vldgeorgiev/scuba-gas-analyzer/docs/improvement-plan.md

# Current app improvement plan

Updated 2026-10-14. Implementation has started, one small step at a time, from restored `main`
at `ecde0b9`. See [progress and verification](progress.md) for completed work and pending checks.
Earlier redesign build/test results describe discarded work, not completion of this plan.

This document is the current scope and decision source. The old OpenSpec change drafts have been
removed. The earlier architecture is historical reference only. Create a small specification for
the next change when requested; do not recreate the discarded framework.

## Document guide

- Current scope and decisions: this document.
- Current delivery sequence: the numbered steps below.
- Architecture, ownership, and messaging: [architecture](architecture.md).
- Implementation status, decisions, and verification: [progress](progress.md).
- Historical only: [Earlier architecture](historical-simplified-architecture.md),
  [discarded implementation build evidence](historical-dependency-baseline.md), and
  [earlier review](historical-claude-review.md). These are not current requirements or validation.

## Scope and decisions

- Keep PlatformIO and the ESP32-S3 board. Leave `esp32dev` explicitly experimental.
- Use unmodified Adafruit ADS1X15. No driver fork, custom register driver, or transport hierarchy.
  Use its non-blocking conversion API with an application polling deadline and a Wire timeout.
  Accept that individual I2C transfer failures are not exposed and may produce plausible values.
- Preserve current gas formulas, gains, sample rate, polarity, and calibration targets initially.
  Fix invalid inputs and numerical defects separately with focused tests. No gas-model refitting,
  new temperature compensation, sensor/electrical redesign, or accuracy-certification work.
- Do not clamp finite O2/He percentages or CO ppm to nominal full-scale display values. Keep
  over-range readings visible; retain input, calibration, and finite-value guards.
- Remove `RunningAverage` and the application-level 20-conversion batches for normal gas readings.
  Use one fresh ADC conversion per enabled channel per acquisition cycle, keeping the ADC data rate
  unchanged. The ADS1115 hardware provides internal digital filtering; the Adafruit library reads
  its conversion result, rather than performing an equivalent 20-sample software average.
  Removing the extra averaging is a deliberate latency/noise tradeoff, not numerical equivalence.
- The user designs the replacement UI in LVGL Editor. LVGL 9.5.0 was explicitly approved on
  2026-09-16 and the exported C now compiles with the firmware.
- Decision 2026-09-16: activate the exported UI now; do not retain an EEZ runtime fallback. Keep
  generated sources untouched and application bindings in a handwritten adapter. Generated
  Calibration, Calibration Run, Firmware Update, and Diagnostics screens are now integrated.
- Calibration must have a live millivolt graph, cancellation, and automatic stability-gated
  completion. These are required improvements, not an indefinite backlog item.
- Add configurable inactivity sleep and button wake. CO uses a 14,000 ms post-power window and is
  Warming in that window above zero ppm; He is Warming below its policy temperature threshold. Raw mV
  remains visible.
- Keep individual Preferences keys, defaults, and one validated RAM settings value. No settings
  blobs, migration, schema versions, CRCs, redundant records, or atomic multi-key guarantees.
- Translation work (2026-10-19): use the Editor translation table for English/Bulgarian text, default
  to English, and persist language through the existing Settings save-on-exit path. UI owns preview
  and LVGL language changes; analyzer owns validation and the individual Preferences key. Keep
  generated files untouched. Language changes do not invalidate measurements or calibration.
  Translate all built-in UI text, including runtime states/results, dialogs, options, placeholders,
  firmware-update feedback, sleep failures, and displayed diagnostic messages; retain user data and
  technical symbols/units unchanged.
- Preserve existing OTA access while moving release downloads from the fixed DigitalOcean object to
  the stable GitHub Release asset URL. Versioned release automation and an on-screen firmware version
  are active scope in step 8. Authenticate GitHub and its release redirect with maintained root CAs
  after bounded NTP synchronization; fail closed when time or TLS verification fails.
- Keep the current README unchanged during planning; update user documentation after implementation.
- External O2 jack (2026-10-14): GPIO13 detection temporarily disables He/CO power and acquisition,
  preserving saved settings and the existing O2 enable/ADC path. LOW currently means plugged
  in. Keep this small: no queue clearing, generation change, new UI messages,
  or calibration-switch protection. Internal and external O2 have separate persisted air/pure
  calibration sets, selected by the jack; existing internal keys remain unchanged. Readings and
  calibration select differential A0/A1 for external O2 or A2/A3 for internal O2 on ADC1 (`0x49`);
  the jack does not switch analog wiring. Startup, polling,
  and resume use the current jack state; unplugging restores settings and normal warm-up.
  See architecture and tests.

## Design limits

- Two persistent application execution contexts: UI and analyzer. A temporary worker may perform
  Wi-Fi scan/update work without calling LVGL. No extra manager, logger, battery, or monitoring task.
- UI owns widgets and draft settings. Analyzer owns ADCs, sensor power, calibration, effective
  settings, and persistence. Callbacks submit work and return promptly.
- Use fixed-size messages: latest measurement, a small command queue, reliable completion,
  and coalesced calibration progress. No general event framework or multi-operation scheduler.
- Allow one state-changing user operation at a time. Cancellation targets that operation; startup
  calibration uses the same busy state. Define queue-full and late-cancel behavior explicitly.
- Keep one measurement-generation counter to reject cached readings from before settings changes.
  Ordinary settings drafts must not overwrite calibration coefficients.
- Prefer concrete components and free functions. Keep only test boundaries that provide useful
  failure coverage. Do not prescribe a new directory tree or rename working files for appearance.
- Use fixed-capacity application buffers. Do not promise allocation-free internals in third-party
  libraries. Measure actual heap/stack demand before optimizing.

## 1. Establish a small verification baseline

Record and pin the currently working dependency set without upgrading it. Keep debug/release
profiles, a native test command for portable production logic, and automated checks for tests and
target builds. Add tests as behavior is changed, not a complete fake infrastructure upfront.
Validate a small Editor export independently so it does not delay urgent correctness fixes.

Acceptance: documented build/test commands and unchanged USB/touch configuration.

## 2. Make readings and failures predictable

Progress: normal-reading batch averaging is removed (step 2a); initialized readings, conversion
guards, checked integer presentation, and cycle error reset are implemented (step 2b).
Latest-only measurement publication and UI-clock stale suppression are implemented (step 2c).
ADC polling deadlines and independent readiness/retry are implemented (step 2d). Explicit channel
state and a temporary status-label adapter are implemented (step 2e). See
[verification details](progress.md).

Initialize every measurement field. Distinguish disabled, warming, valid, invalid, and unavailable;
compute staleness in the UI even when acquisition stops. Never replace unknown values with zero
or show the last good value as current. Guard MOD, denominators, non-finite values, and integer
conversions. Apply the existing He correction when O2 is enabled and usable; use the uncorrected
baseline when O2 is disabled. Preserve raw diagnostics.

Use stock Adafruit conversion start/poll/result calls with a timeout. Initialize ADCs independently,
retry failed initialization or observed timeouts with simple backoff, and read temperature only
when needed. Preserve ADC gains and data rate, but replace each 20-conversion gas batch with one
fresh conversion. Neither range checks nor the polling deadline prove that an individual I2C
exchange succeeded.

Remove the normal-reading average buffers and do not replace them with another smoothing filter.
With all channels enabled at 128 SPS, this reduces the conversion count from 61 to 4 per cycle:
approximately 477 ms to 31 ms of nominal conversion time, excluding bus and scheduling overhead.
This reduces acquisition latency but does not automatically increase UI refresh frequency; review
the task wait interval so a fixed delay does not hide the benefit. Do not automatically reintroduce
smoothing if noise rises; review the tradeoff.

The `RunningAverage` dependency was retired after calibration moved to the bounded stability window
in step 5. That window is evidence for calibration, not normal-reading smoothing.

Acceptance: focused tests for invalid/disabled values, stopped producer, independent readiness,
timeout/recovery, clock wrap, and exactly one fresh conversion per enabled channel (temperature only
when needed). Verify readings are derived from that conversion without a batch average. Target stale
indication within two seconds of the last usable sample, including UI refresh latency. The stock
library cannot detect every bus failure.

## 3. Establish task ownership and add sleep

Decision updated 2026-09-15: bring the full analyzer/UI task restructuring forward from step 4
to avoid accumulating temporary synchronization. Step 3a's interim gate is replaced by step 3b:
one analyzer task, one UI task, and a small fixed command/result path. The gate, `configOpen`,
GUI mutex, separate screen-update task, and arbitrary startup delay are removed.
Step 3c implements analyzer-owned preparation/resume and the fixed CO startup interval. Step 3d
adds the persisted timeout, configuration dropdown, and tested activity/debounce policy. Step 3e
enables S3 automatic entry, display/touch shutdown, abort/resume, and GPIO14 wake with confirmed-wake
calibration preservation.

The analyzer owns ADCs, sensor-enable GPIOs, calibration, effective RAM settings, and Preferences.
UI callbacks submit one operation at a time and receive an outcome with effective values and a
measurement generation. Acquisition continues while settings are open. Calibration runs as an
incremental analyzer-owned session with cancellation and bounded progress.
The UI initializes and updates all graphics objects in one task. Block the unused Arduino loop.

Default timeout: 5 minutes. Options: Off, 1, 2, 5, 10, and 30 minutes; wake on GPIO14/button 2.
Persist the selected timeout; use 5 minutes when the stored value is missing or invalid.
Measure touch/button inactivity, not redraws. Inhibit sleep during calibration, pending settings,
Wi-Fi scans, and OTA using explicit activity flags, not a nested inhibitor registry. Start a fresh
idle interval after operations finish.
Keep sleep inhibited while Settings is open so its current draft is not lost to sleep. Closing
submits the draft; if saving is rejected, restore effective settings and do not retain those edits.

Deliver ownership and sleep against the existing UI before the replacement UI. Reuse the analyzer
command path for sleep preparation/resume and owner-driven sensor power timing. No more temporary
shared-access gates. Do not wait for the Editor export or hand-edit generated UI output.

Ask the analyzer to prepare for sleep with an ID and timeout. Reject preparation while busy.
After acknowledgement, power down the display/touch/backlight and radio as supported, then enter
deep sleep. An aborted preparation must restore usability and resume acquisition; ignore late
acknowledgements. Keep this a small explicit sequence, not a general rollback framework.

Validate the expected wake cause plus a simple consumed application-sleep marker. Load persistent
settings and skip automatic startup calibration only on confirmed application wake. Restart the
CO interval. Report missing/invalid calibration; do not present it as an accepted calibration just
because a numerical default exists. Wait for button release before arming and consume/debounce
the wake press. Configure GPIO output hold/pull behavior according to the board requirements.

Acceptance: five-minute default, missing/invalid timeout fallback, Off and all timeout options,
busy inhibition, abort/resume, held button, and retained settings.

## 4. Finish settings behavior and acceptance

Ownership, RAM settings, complete-candidate validation, checked changed-key writes, acknowledged
reset/clear, and generation filtering have moved into step 3b because the task handoff needs them.
Do not repeat that restructuring. Keep individual Preferences keys and explicit best-effort
persistence: a failed multi-key write may have stored a prefix even though runtime state is retained.
An in-session retry rewrites the complete candidate before reporting success after such a failure.

Step 4a implements field-specific invalid-load recovery, preserving unrelated valid values and
repairing dependent pO2/O2 pairs. It retains the visible warning and startup-calibration suppression
when non-timeout fields need repair. No load-time writes, versioning, or migration machinery added.
Step 4b validates stored O2-air and He calibration independently on cold boot and wake. Unrelated
repairs preserve accepted calibration; missing/invalid channels suppress affected derived readings.
Ordinary saves cannot accept RAM fallback coefficients. Existing float keys retain NaN for unaccepted
calibration, and explicit successful calibration/reset accepts only its own channel. Results name
required channels; raw O2/He diagnostics remain available. Step 4c was simplified at the user's request:
save on exit, restore effective settings and report failure if rejected, and do not retain failed edits.
One editing flag prevents asynchronous results overwriting an open editor. No discard controls or
retained-draft sleep inhibition; only the open editor and pending operations inhibit sleep.
Save-on-exit and apply/reset/clear behavior are implemented.
Calibration-required reading labels use the existing Invalid state; detailed calibration outcomes
identify the channels that require calibration.
Check that calibration outcomes cannot overwrite in-progress editable settings drafts, and that
old-generation readings never accompany new coefficients. Keep tests focused on product behavior.

Step 4d (2026-10-14) adds a persisted CO correction setting (+2 to -5 ppm, default 0, added to the
measured value) to the
existing Settings save-on-exit path; see architecture. Host tests cover storage, repair, mapping,
and subtraction.

Acceptance: tests cover retained settings and reset/clear behavior, write failures are reported
accurately, and display updates do not repeat NVS reads. No new store framework.

## 5. Complete stability-gated calibration

Implementation status: manual and enabled cold-boot calibration share one incremental session.
Spread and drift qualification, cancellation, persistence-gated completion, and legacy averaging
removal are complete with the current thresholds.

Use one incremental calibration session for manual and enabled cold-boot calibration. Collect fresh
timestamped millivolt samples into a fixed rolling window. Require minimum sample count/coverage,
low spread and low drift. Decision 2026-09-17: add drift detection to the existing rolling-range
check; additional sample-gap qualification and continuous stable dwell are not in scope for now.
Keep existing invalid-sample handling and the five-second minimum/ten-second maximum session.
Never force acceptance merely because time elapsed.

Feed the window individual fresh conversions, not pre-averaged batches. Replace calibration's
`RunningAverage` objects with this fixed-capacity history and remove the library dependency once
unused. A mean of the final qualified window may still be used to estimate the coefficient; this
does not restore continuous smoothing to normal measurements.

Compute the candidate from the final stable window, validate, persist, then apply. Cancellation,
sampling failure, invalid input, timeout, and reported write failure retain the previous live
calibration. Define late cancellation after successful application as already completed, not undone.
Publish bounded history/progress independently of screen refresh. Thresholds are code constants,
not new user-facing settings. Accept O2-air candidates from 5 through 20 mV, pure-O2 candidates from
30 through 100 mV, and helium candidates at or above 400 mV. Calibration and warm-up constants are
centralized in `src/app/AnalyzerPolicy.h`. No CO calibration workflow is added.

Acceptance: tests for steady input, noise, positive/negative slow drift, settling, spikes, timeout,
cancellation, and clock wrap. Sample-gap and additional dwell changes are deferred. A hidden or slow
graph must not change the result. Use bounded acquisition steps only if needed, without changing ADC
rate or adding another task.

## 6. Integrate the replacement UI

### Active migration checklist (2026-09-16)

- [x] Compile checked-in exported C, fonts, and images with LVGL 9.5.0 in both S3 profiles.
- [x] Exclude EEZ from the active firmware; replace `ui_init`, `ui_tick`, Flow globals, and direct
  EEZ widget references. Keep existing analyzer/UI ownership and message queues.
- [x] Initialize unavailable readings before loading Main. Bind percentages, mV, He temperature,
  guarded Bottom/Deco MOD, battery, warning-log indicator, and CO danger-colour policy.
- [x] Wire Main/Large screen taps after all permanent screens exist. Keep Settings/Calibration
  actions separate, create Settings on entry, and delete it after returning to Main.
- [x] Connect settings subjects to open/save callbacks, index conversion, effective-value rollback,
  brightness preview, sleep policy, and calibration-coefficient protection.
- [x] Integrate generated Calibration, Calibration Run, Firmware Update, and Diagnostics screens.
- [x] Test real LVGL initialization/rendering, navigation, settings rejection and lifetime, sensor
  status formatting, and all existing portable behavior. Compile debug and release firmware.
- [x] Re-export the renamed logo object in the Editor and verify direct-library builds and host tests.
- [x] Prepare component-based `calibration.xml`, `firmware_update.xml`, and `diagnostics.xml`.
- [x] Export and verify the new screens, wire their controls, and remove handwritten action dialogs.
- [x] Implement manual calibration graph/progress/cancellation UI and stability gating.
- [x] Route enabled cold-boot calibration through the timed session and remove `RunningAverage`.
- [x] Delete the retired EEZ project, generated runtime/assets, unused widget test fakes, and
  obsolete PlatformIO exclusions. Git history retains the previous implementation.

Build integration uses `lvgl-ui-project/library.json` and a local
`gas-analyzer-ui=symlink://lvgl-ui-project` dependency. PlatformIO compiles exported sources directly,
excluding simulator/preview/tests. The Python build hook, staging, and logo workaround are removed
after a fresh Editor export. No checked-in generated C is manually edited. The library enables
uninitialized-variable build errors to catch regressions such as the former logo-name collision.
Firmware callbacks replace generated navigation listeners after initialization, retaining their
delete-time cleanup callbacks. This handles permanent-screen creation order and avoids capturing
a NULL destination. Keep styles deferred; only safety status presentation and required layout
behavior are adjusted during integration.

Generated action screens use fixed navigation beside scrolling content, global spacing tokens,
and existing components. Calibration exposes the startup preference, Air/Pure-O2/He calibration,
Pure-O2 clear, and Diagnostics navigation. Firmware Update exposes
network selection, scan, a masked password field and keyboard, connection status, and Install.
Its keyboard takes layout space rather than covering the password; other form controls hide while
editing. Install starts disabled until the adapter sets `update_can_install`.
Diagnostics shows a wrapping `diagnostics_log_text` subject. These controls are wired through
`UiAdapter`. In particular, `update_back` intentionally has
no screen-create event: integration must return to the existing Settings draft without recreating it.
XML syntax/reference checks are not a substitute for a fresh Editor export, rendering, and
keyboard/navigation tests.

Bind the user's actual Editor export through a thin adapter. Preserve normal/large readings, MOD,
channel settings, calibration/reset, startup calibration preference, brightness, battery, logs,
fault status, OTA access, and sleep configuration. Add the calibration graph, elapsed time,
stability status, Cancel, and a retained final result. Do not invent generated filenames in advance.

The retired UI sources/assets and handwritten action dialogs are removed. Shared component styling
remains the source for generated controls.

Acceptance: compatible export compiles, regeneration preserves handwritten code, navigation stays
responsive, and invalid/disabled/warming states are understandable. Consult the LVGL MCP server
and verify APIs against the selected version before implementation. Export compilation and host
adapter behavior are verified. A future Editor change should still be regenerated and built before
delivery.

## 7. Measured cleanup

Decision 2026-09-17: retain the existing Diagnostics screen and logging behavior. The device is used
for short sessions and can be reset to clear errors. A new log buffer, separate active-fault tracking,
recovery history, and duplicate rate-limiting are not required; do not implement that redesign.

Decision 2026-09-17: cache the ESP battery ADC characterization instead of rebuilding it for every
sample. Battery sampling cadence, rounding/truncation changes, buffer or scheduling optimization,
and additional operational documentation are not current issues and are not active work.

The one-time battery ADC initialization is implemented in the display-owned battery module. The
fixed-capacity UI log now copies a caller-owned snapshot while locked rather than returning mutable
shared storage; its visible behavior is unchanged. No further measured cleanup is planned unless
device behavior identifies a concrete problem.

## 8. Automate tested, versioned releases

Decision 2026-09-18: automated push CI is removed. The manually dispatched release workflow owns
host testing, release compilation, packaging, and publication. The GitHub Release OTA URL and the
on-screen compile-time version are implemented. OTA uses CA-validated TLS after bounded NTP setup.

### Local verification

There is no workflow on push or pull request. Run both host environments locally before ordinary
changes:

```sh
pio test -e native -e native-ui
```

Run relevant S3 builds locally according to the affected surface. These checks do not tag, publish,
upload, flash, or perform OTA.

### Manual release

The separate `workflow_dispatch` release workflow operates on the explicitly selected commit,
uses a concurrency group to prevent two releases allocating the same version, and requires
`contents: write`. Restrict release commits to the default branch unless an intentional override is
designed later.

Use UTC CalVer tags in the form `vYYYY.MM.DD` for the first release of a day. Additional releases on
the same date use `.2`, `.3`, and so on. Derive the next value from existing matching repository tags;
legacy `.1` tags count as the first daily release. Do not use run number as the public version.
Existing non-CalVer tags such as `proto-board-1` do not participate. The same calculated value must
identify the Git tag, GitHub Release, metadata, and compiled firmware.

The release workflow must:

1. Check out full history and tags, calculate and validate the next CalVer, and fail if the tag exists.
2. Run `pio test -e native -e native-ui` before packaging.
3. Build `t-display-s3-release` once with the calculated version injected as a compile definition.
4. Package `.pio/build/t-display-s3-release/firmware.bin` without rebuilding it under another version.
5. Generate a SHA-256 checksum and metadata containing at least version and commit SHA.
6. Create the immutable GitHub Release with `firmware.bin`, checksum, and metadata assets.
7. Create/push the tag for the exact tested commit only after validation and packaging have succeeded;
  avoid leaving a published tag when release creation fails, or make reruns idempotently recoverable.

The GitHub Release asset is the durable OTA publication surface and provides the stable anonymous
device URL.

### Firmware version and update screen

One application-owned compile-time firmware version constant supplies the UI. Ordinary local, debug, and CI builds
use an explicit development fallback such as `dev`; the release workflow injects the calculated tag.
Avoid deriving the displayed value at runtime or maintaining an independently edited version file.
The release workflow supplies the compile definition through PlatformIO's documented
`PLATFORMIO_BUILD_FLAGS` environment override.

The Editor export defines `firmware_version_text` and binds it to the `firmware_version` label on the
Firmware Update screen. `src/display/UiAdapter.cpp` copies the compile-time constant into that subject
before the transient screen opens. `test_exported_ui` asserts that the bound label equals the compiled
value, including the development fallback in host tests.

### OTA publication URL

The updater's download target is the stable latest-release asset URL:

```text
https://github.com/vldgeorgiev/scuba-gas-analyzer/releases/latest/download/firmware.bin
```

The release workflow must always attach the asset with the exact name `firmware.bin`; versioning
belongs in the tag, release title, and metadata rather than the OTA asset filename. Preserve
redirect following through GitHub's `latest` endpoint to release asset storage.

### TLS authentication

The update worker synchronizes UTC from three NTP servers with a ten-second timeout before opening
HTTPS. `WiFiClientSecure::setCACert()` receives concatenated USERTrust ECC and ISRG Root X1 trust
anchors, covering `github.com` and `release-assets.githubusercontent.com` respectively. Time setup,
certificate validation, hostname validation, or connection failure cancels the update; there is no
insecure fallback. Review the redirect chains and replace trust anchors before their 2038 and 2035
expirations or when GitHub changes its chains.

Acceptance: a manual release passes both host suites and produces one CalVer used consistently by the
binary, screen, tag, GitHub Release, and metadata; checksum verification passes; the latest-release
URL returns that exact binary; local
builds show `dev`; reruns and same-day releases cannot overwrite or ambiguously reuse a version.
TLS trust authentication must fail closed when NTP or certificate validation fails.

## 9. Migrate to LVGL 9.6.0

This is future work. Keep LVGL 9.5.0 pinned until the installed LVGL Editor and its exporter support
9.6.0, then upgrade the Editor project, generated library, firmware dependency, host tests, and
configuration together. Follow the official
[LVGL 9.5 to 9.6 migration guide](https://lvgl.io/docs/open/changelog/migration-v9-6#lv_obj).
LVGL 9.6 is the final v9 release, and APIs deprecated there are removed in v10.

- [ ] Confirm LVGL Editor can target 9.6.0 and regenerate the project without hand-editing exported C.
- [ ] Refresh `lv_conf.h` from the 9.6 template and reapply this project's settings, including the
  72 KiB memory pool, explicit color format, enabled widgets, fonts, and host-test configuration.
- [ ] Use the 9.6 public include layout and remove direct private or compatibility-mapped API usage.
- [ ] Migrate generated and handwritten Subjects from `lv_subject_init_*`/`lv_subject_deinit` values
  to `lv_subject_create`/`lv_subject_delete` pointers, preserving initial values, ranges, and buffer
  lifetimes.
- [ ] Replace generic object flag calls with dedicated APIs such as `lv_obj_set_hidden()` and
  `lv_obj_is_hidden()`; audit other renamed or deprecated object, display, span, and widget APIs.
- [ ] Move disabled-sensor visibility to shared O2, He, and CO Subjects only when the 9.6 Editor
  exports the supported boolean binding (`lv_obj_bind_bool(..., lv_obj_set_hidden)`). Do not introduce
  the deprecated `lv_obj_bind_flag_if_*` family. If the exporter cannot represent this binding, keep
  visibility in `UiAdapter` with `lv_obj_set_hidden()` until it can.
- [ ] Build with deprecation warnings visible and remove reliance on the v9.5 compatibility map.
- [ ] Run `pio test -e native -e native-ui` and build both S3 profiles before changing the pinned
  version.

Acceptance: a fresh 9.6.0 Editor export and all handwritten code compile without LVGL deprecation or
compatibility warnings; host suites and both firmware profiles pass; generated sources remain
untouched.

## Deferred

- This low-risk device does not require an OTA manifest, downgrade policy, or rollback protocol.
- Rotation, remembered screen, translations, units, calculators, and startup-calibration change warnings.
- ADC rate changes/interleaving, polynomial optimization, DMA, and display-driver replacement.
- New gas models, chemistry/hardware research, and additional power modes or wake sources.

## Implementation order

Deliver the baseline and reading fixes (1-2), then task ownership and sleep/wake (3), remaining settings
behavior (4), calibration (5), the replacement UI (6), measured cleanup (7), and versioned release
automation (8). Defer the coordinated LVGL 9.6.0 migration (9) until Editor/export support is verified.
Editor compatibility can proceed independently. Keep one current
checklist per active change. Do not resume the discarded redesign. Update architecture and progress
alongside meaningful changes. Use Claude for bounded independent review when useful, particularly
sleep and calibration; no OpenSpec scaffolding is required for small changes.
