vldgeorgiev/scuba-gas-analyzer/docs/images/box/readme-front.png

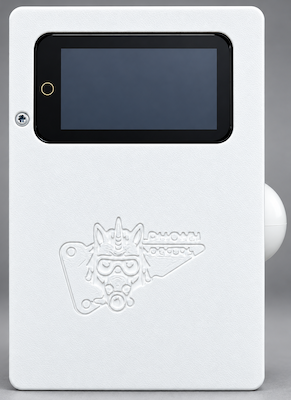
docs/images/box/readme-front.png
