vldgeorgiev/scuba-gas-analyzer/docs/images/box/readme-inlet.png

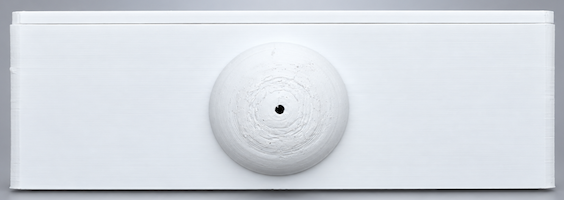
docs/images/box/readme-inlet.png
