vldgeorgiev/scuba-gas-analyzer/docs/images/box/readme-side.png

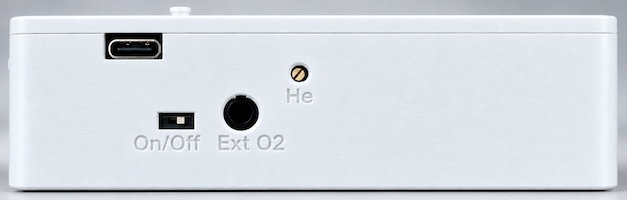
docs/images/box/readme-side.png
