vldgeorgiev/scuba-gas-analyzer/hardware/enclosure/exports/parts.3mf

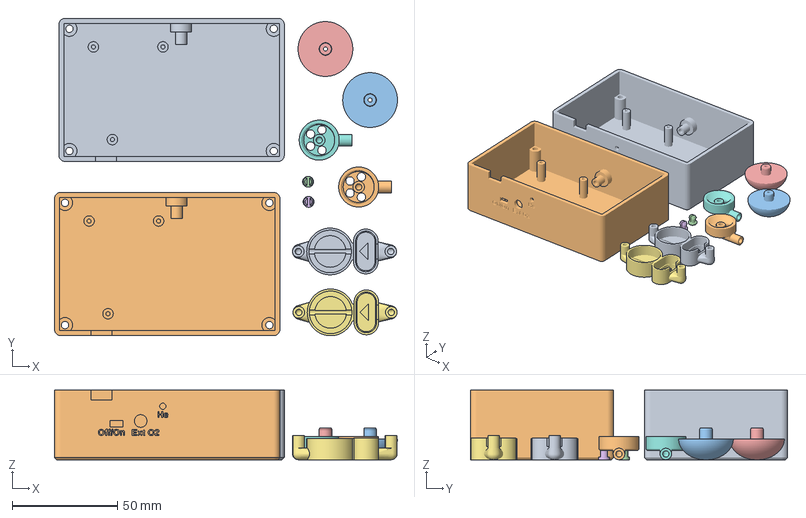
[picture p9: CAD file, 2026-10-30]
hardware/enclosure/exports/parts.3mf
162.8 x 150.7 x 33.0 mm
enclosure.stl x 2
flow_limiter.stl x 2
wake_button_pin.stl x 2
co_he_sensor_holder.stl x 2
o2_sensor_holder.stl x 2
