vldgeorgiev/scuba-gas-analyzer/hardware/enclosure/exports/lid_inlay.3mf

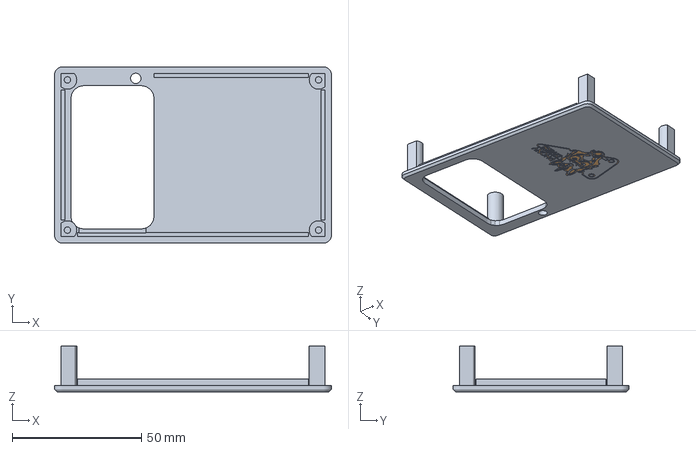
[picture p10: CAD file, 2026-10-30]
hardware/enclosure/exports/lid_inlay.3mf
107.0 x 68.0 x 17.7 mm
lid
lid_logo
