vldgeorgiev/scuba-gas-analyzer/docs/user-manual.bg.md

# Ръководство за работа с газовия анализатор

Този анализатор е самоделно устройство и не е сертифициран. Употребата му е на ваша отговорност.

## Измерване на газ

Включете анализатора и изчакайте всички включени сензори да се стабилизират. Главният екран показва съдържанието на кислород, хелий и въглероден оксид, състоянието на батерията и напреженията на сензорите. Докоснете областта с показанията, за да превключите между компактния изглед и изгледа с големи цифри.

Главен екран с показания

Екран с големи цифри

`Загрява` (`Warming`) означава, че сензорът все още не е готов. `Стари данни` (`Stale`) означава, че няма скорошно валидно измерване; изчакайте ново показание, преди да разчитате на него. `Няма данни` (`Unavailable`) означава, че липсват данни от сензора или от допълнително измерване, необходимо за изчислението. Докоснете индикатора за предупреждение, за да отворите **Диагностика** и да видите последните предупреждения и грешки.

### MOD, CO и батерия

Стойностите `B` и `D` под показанието за кислород са максималните работни дълбочини (MOD). Те се изчисляват от измерения процент кислород и зададените в **Настройки** граници за парциалното налягане на кислорода (ppO2). `B` използва настройката **Дънно pO2**, а `D` - **Деко pO2**. Проверете избраните граници и анализа на газа, преди да използвате тези дълбочини.

Показанието за CO се оцветява в червено при стойност над 0 ppm. Проверете газа и не го използвайте, докато не бъде потвърдено, че е безопасен.

Напрежението на напълно заредената батерия е около 4,2 V. Заредете я, преди напрежението да спадне до около 3,0 V. Настройката **Заспиване** определя след колко минути бездействие анализаторът да премине в режим с ниска консумация. Изберете `Никога` само ако е необходима непрекъсната работа. Заспиването значително намалява разхода на батерията, когато уредът не се използва. Не изключвайте анализатора по време на обновяване на фърмуера.

## Външен O2 сензор

Свържете външния сензор за O2 към коаксиалния жак. Анализаторът го разпознава и изключва
захранването на сензорите за He и CO, без да променя запазените им настройки. След разкачване
уредът отново използва вътрешния сензор за O2 и възстановява текущите настройки за He и CO.
Изчакайте включените сензори отново да се стабилизират. O2 трябва да е включен в **Настройки**.

За вътрешния и външния сензор за O2 се пазят отделни калибрирания с въздух и, по желание, с чист
кислород. Калибрирайте външния сензор преди първата употреба. Ако за избрания сензор няма валидно
калибриране с въздух, показанието за O2 е `Невалидно` (`Invalid`), но напрежението на сензора остава
видимо. Уредът пази само един комплект калибрирания за външен сензор, а не отделен за всеки
свързван сензор. Затова калибрирайте отново при смяна на външния сензор.

## Калибриране

От главния екран докоснете бутона с кръгова стрелка, за да отворите **Калибриране**. Изберете опцията според използвания референтен газ:

- **Въздух (20.9%)** - калибриране на сензора за O2 с въздух.
- **O2 (100%)** - калибриране на сензора за O2 с чист кислород.
- **He (100%)** - калибриране на сензора за He с чист хелий.

Калибрирането на O2 автоматично използва избрания сензор: разкачете външния, за да калибрирате
вътрешния, или го свържете, за да калибрирате външния. Преди калибриране с чист кислород трябва
да има валидно калибриране с въздух за същия сензор. Нулирането на калибрирането и изтриването
на калибрационната точка за чист кислород засягат само избрания сензор. Не свързвайте и не
разкачвайте външния сензор по време на калибриране. Преди калибриране на хелий разкачете външния
сензор за O2.

Избор на калибриране

Стартирайте калибрирането едва след като осигурите стабилно подаване на референтния газ към сензорите. Анализаторът следи показанието и изчаква то да се стабилизира. При стабилно показание записът се извършва най-рано пет секунди след началото. Когато калибрирането завърши, графиката спира и се показва `Записано` (`Saved`). Натиснете **Готово**, за да се върнете към екрана за калибриране. По време на калибрирането можете да го прекратите с **Отказ**.

Завършено калибриране с въздух

Ако се появи съобщение за стойност извън допустимия диапазон, нестабилен сигнал или неуспешен запис, проверете референтния газ и връзката на сензора. Уверете се, че сензорът е загрял, и опитайте отново.

Настройката **Въздух при старт** е изключена по подразбиране. Когато е включена, избраният сензор за O2 се калибрира с въздух при включване на уреда. При събуждане след автоматично заспиване калибрирането се запазва и не се повтаря. Преди включване продухайте уреда с въздух, за да няма остатъчен газ. Газ с различно съдържание на кислород може да доведе до неправилно калибриране.

## Настройки

От главния екран отворете **Настройки**, за да включите или изключите сензори и да зададете корекцията за CO, границите за ppO2, яркостта, езика и времето до заспиване. Промените се записват при излизане от екрана. Ако анализаторът е зает или въведената стойност е невалидна, предишните настройки остават в сила и се показва съобщение за грешка.

**Корекция CO** компенсира постоянно отклонение в показанието на сензора за CO в чист въздух. Изберете стойност от `+2` до `-5` ppm; анализаторът я добавя към всяко измерване на CO. Например, ако в чист въздух се показва `3 ppm`, изберете `-3`. Стойността по подразбиране е `0`. При твърде голяма отрицателна корекция показанията може да паднат под нулата.

## Обновяване на фърмуера

Отворете **Настройки**, след това **Обновяване**. На екрана се показва инсталираната версия на фърмуера.

1. Докоснете бутона с кръгова стрелка, за да потърсите Wi-Fi мрежи.
2. След края на търсенето изберете своята мрежа.
3. Въведете паролата за мрежата.
4. Натиснете **Инсталиране** и оставете анализатора включен до края на обновяването.

Обновяване на фърмуера

Съобщението за състояние показва текущата стъпка при свързване с мрежата или инсталиране на фърмуера. Не стартирайте друга мрежова операция, докато търсенето на мрежи или обновяването е в ход.
