vldgeorgiev/scuba-gas-analyzer/docs/testing.md

# Testing

This is the maintained reference for automated checks. Update it when a test suite, PlatformIO test
environment, or validation boundary changes. Historical test results remain in
[progress.md](progress.md); they are not the source of truth for the current test layout.

## Quick commands

The tests use PlatformIO Core 6.2.0. If `pio` is not on `PATH`, use
`~/.platformio/penv/bin/platformio` in its place.

```sh
# Portable logic tests
pio test -e native

# Real LVGL host integration tests
pio test -e native-ui

# Complete host check
pio test -e native -e native-ui

# Local firmware compile checks
pio run -e t-display-s3 -e t-display-s3-release
```

Run one portable suite with PlatformIO's test filter, for example:

```sh
pio test -e native -f test_conversions
pio test -e native -f test_sensor_reads
```

No command above uploads or flashes firmware, or validates physical sensors,
touch, display layout, power consumption, deep sleep, or wake behavior. The S3 build compiles the
firmware but does not execute it.

## PlatformIO test environments

The authoritative environment definitions are in [`platformio.ini`](../platformio.ini).

| Environment | Purpose | Test selection | Production sources compiled |
| --- | --- | --- | --- |
| `native` | Portable application, settings, conversion, acquisition, and sleep logic | All `test/test_*` suites except `test_exported_ui` | `sensors/conversions.cpp`, `sensors/sensors.cpp`, `app/Analyzer.cpp` |
| `native-ui` | Exported UI, adapter, and feedback against real LVGL 9.5.0 | Only `test_exported_ui` | `display/UiAdapter.cpp`, `display/UiFeedback.cpp`, `sensors/sensors.cpp`, `sensors/conversions.cpp` |

Both environments use PlatformIO's Unity test framework and C++17. `native` adds `-Wall -Wextra`.
The embedded environments inherit `test_ignore = test_*`, so firmware builds do not discover or run
host tests.

Host isolation is provided by [`test/fakes`](../test/fakes). These replacements model Arduino time,
GPIO, Preferences, FreeRTOS queues, ADS1115 devices, and related platform services. They permit
deterministic failure, timeout, clock-wrap, queue-full, and persistence scenarios without a board.
They are behavioral fakes, not hardware or scheduler emulation.

## Portable native suites

Current inventory: **133 tests**. The registration lists at the bottom of each suite source are the
authoritative individual test names.

| Suite | Tests | Coverage | Primary implementation references |
| --- | ---: | --- | --- |
| [`test_analyzer`](../test/test_analyzer/test_analyzer.cpp) | 67 | Command/result admission, effective settings, Preferences reconciliation, language persistence/default/invalid fallback/rejection without measurement invalidation, CO correction persistence/repair/application, calibration acceptance and stability, startup behavior, measurement generations, shared sensor power, CO warm-up, external O2 detection and He/CO suppression at startup/hot-plug/resume, independent internal/external O2 readings and calibration persistence/reset/clear/acceptance/partial-write recovery, sleep prepare/resume, queue pressure, and settings editor acknowledgement | [`src/app/Analyzer.cpp`](../src/app/Analyzer.cpp), [`src/app/Analyzer.h`](../src/app/Analyzer.h), [`src/app/AnalyzerPolicy.h`](../src/app/AnalyzerPolicy.h), [`src/settings/SettingsStore.h`](../src/settings/SettingsStore.h) |
| [`test_sensor_reads`](../test/test_sensor_reads/test_sensor_reads.cpp) | 34 | One-conversion sensor reads, raw/derived values, signed He millivolts with magnitude-based percentage and oxygen correction, O2-independent He baseline, ADC initialization and timeout handling, per-device recovery, channel states, latest-value queue semantics, freshness, clock wrap, calibration acquisition, and warm-up classification | [`src/sensors`](../src/sensors), [`src/sensors/sensors.cpp`](../src/sensors), [`src/sensors/conversions.cpp`](../src/sensors/conversions.cpp) |
| [`test_sleep`](../test/test_sleep/test_sleep.cpp) | 16 | Timeout persistence, inactivity policy, wake-button debounce, retained wake marker classification, prepare/resume interruption, and calibration behavior across cold boot and application wake | [`src/app/SleepPolicy.h`](../src/app/SleepPolicy.h), [`src/app/Analyzer.cpp`](../src/app/Analyzer.cpp), [`src/settings/SettingsStore.h`](../src/settings/SettingsStore.h) |
| [`test_conversions`](../test/test_conversions/test_conversions.cpp) | 16 | O2, He (including high-O2 compensation zero floor), CO (including correction), temperature, MOD and integer conversions; finite/range guards; presentation and diagnostic formatting; settings selection mapping | [`src/sensors/conversions.cpp`](../src/sensors/conversions.cpp), [`src/display/UiPresentation.h`](../src/display/UiPresentation.h) |

These suites compile selected production sources with the platform fakes. They do not compile the
entire firmware or the generated LVGL UI.

The sensor-read suite checks He AIN1-minus-AIN0 software polarity for both signs, while keeping
percentage magnitude, oxygen correction, zero behavior, and magnitude-based calibration unchanged.

The analyzer suite checks ADC1 differential selection: internal O2 readings/calibration use A2/A3,
external O2 readings and air/pure calibration use A0/A1. These checks verify requested mux selection.

## LVGL host integration suite

[`test_exported_ui`](../test/test_exported_ui/test_exported_ui.cpp) contains **12 tests** and runs only
under `native-ui`. It initializes real LVGL 9.5.0 with a 320 x 170 RGB565 partial display buffer and
uses the actual exported UI library plus [`UiAdapter.cpp`](../src/display/UiAdapter.cpp) and
[`UiFeedback.cpp`](../src/display/UiFeedback.cpp), including real message boxes rather than a counter fake.

It verifies:

- exported boot, nonblank rendering, image binding, screen navigation, and calibration states;
- settings synchronization, save/rejection behavior, CO correction dropdown mapping, brightness, and update-screen actions;
- startup air calibration default-off behavior, enable-only warning, rejected toggles, and warning popup fit without scrolling;
- reading/status text, units, warning styles, channel states, stale data, MOD, and diagnostics;
- English/Bulgarian brightness-label switching, translated Settings recreation, Cyrillic glyph coverage,
  and label fit beside the slider;
- all 15 translated captions across Settings, Calibration, Calibration Run, Diagnostics, and Firmware
    Update, including language round trips, caption visibility and parent bounds, and Cyrillic body/H5 fonts;
- effective-language synchronization, restoration on Settings exit, and screen creation using the effective language;
- exported language-dropdown options, subject synchronization, live preview, save capture, acknowledged
    language application, rejection rollback, reopening, and language-row fit;
- runtime reading/calibration states, every firmware-update event, formatted download progress,
    sleep options, password placeholders, and refresh when changing language;
- real result dialogs, title bounds and Cyrillic-capable fonts, numeric units, cancellation without
    a dialog, diagnostic records with timestamps/numeric data, and diagnostic language refresh;
- repeated dynamic Settings creation/deletion without lost LVGL heap or memory corruption;
- compact control fonts, Cyrillic body/control/H4/H5 glyphs, dropdown main/list/selected fonts,
  text-field main/placeholder fonts, and Calibration screen bounds in English and Bulgarian.

Events are injected directly into LVGL objects. This suite does not exercise the touch controller,
TFT driver, target memory limits, on-device layout, or generated XML in the Editor before export.
Run `native-ui` locally whenever the UI export, UI assets, LVGL configuration, or `UiAdapter`
changes.

The shared LVGL heap is 80 KiB. The language-control integration exposed image scratch allocation
failure with the previous 72 KiB pool. After changing `lv_conf.h`, clean the affected environments
before validation so allocator objects are rebuilt with the updated configuration.

The full runtime catalog now has 109 English/Bulgarian entries in Editor XML. Language choices stay
fixed as `English` and `Български`, independent of the selected UI language. The full catalog and
Cyrillic fonts are exported; the existing runtime translation tests pass with Bulgarian text.
The compact-layout test verifies that Calibration fits the 320 x 170 screen without scrolling in
both languages. Controls use the 14 px Cyrillic font; 7 px button vertical padding compensates for its
18 px line height and preserves the previous text-plus-padding height.

Translation keys must be single-line and safe to embed in C strings. Keep multiline dropdown values
under stable keys such as `sleep_options`; do not use the option lists as keys.
The current Editor exporter escapes translated values but emits newlines in keys directly into C.
After changing keys, re-export before running host UI tests or firmware builds.

To regenerate the screenshots used by the [user manual](user-manual.md), run:

```sh
MANUAL_SCREENSHOTS=1 pio test -e native-ui
for image in docs/images/user-manual/*.ppm; do sips -s format png "$image" --out "${image%.ppm}.png"; done
rm docs/images/user-manual/*.ppm
```

The capture mode records the rendered 320 x 170 LVGL frames for the readings, calibration, and
firmware-update flows. It is disabled during ordinary test runs.

## Choosing validation

Use the smallest relevant suite first, then broaden according to the affected surface:

| Change | Minimum focused validation | Before completion |
| --- | --- | --- |
| Conversion or presentation helper | Relevant `native` suite with `-f` | `pio test -e native` |
| Analyzer, settings, sensors, calibration, or sleep policy | Relevant `native` suite with `-f` | `pio test -e native` and both S3 builds |
| `UiAdapter`, UI export, fonts, images, or LVGL config | `pio test -e native-ui` | Both host environments and both S3 builds |
| Board pins, display/touch driver, deep sleep, wake, or sensor power | Closest host tests and both S3 builds | Explicit physical-device validation remains required |
| PlatformIO test configuration | The command(s) changed by the edit | Run both host environments and affected S3 builds |

Add regression coverage to the existing owning suite. Create another suite only when it needs a
meaningfully different build environment or fixture boundary.

## Maintenance checklist

When tests change:

1. Update the suite count and coverage row here when `RUN_TEST` registrations move or change.
2. Update environment selection and compiled-source notes when `platformio.ini` changes.
3. Keep physical/device limitations explicit; host success must not be described as device validation.
4. Record dated execution results in [`progress.md`](progress.md), not as timeless claims here.

For application behavior behind the tests, consult [`architecture.md`](architecture.md). Agents
should begin with this document, the affected suite row, and the referenced implementation files;
a repository-wide scan should not be necessary for routine test work.
