vldgeorgiev/scuba-gas-analyzer/src/network/TrustedRoots.h

#pragma once

// USERTrust ECC Certification Authority, valid through 2038.
constexpr char GITHUB_ROOT_CA_CERTIFICATES[] = R"CERT(
-----BEGIN CERTIFICATE-----
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
-----END CERTIFICATE-----
-----BEGIN CERTIFICATE-----
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
-----END CERTIFICATE-----
)CERT";
