vldgeorgiev/scuba-gas-analyzer/src/display/UiAdapter.cpp

#include "UiAdapter.h"
#include "UiFeedback.h"
#include "UiPresentation.h"
#include "FirmwareVersion.h"
#include "lvgl_ui_project.h"
#include "main.h"
#include "network/FirmwareUpdate.h"
#include "ui-log.h"
#include "app/SleepPolicy.h"
#include <algorithm>
#include <cmath>
#include <cstring>

namespace ui {
namespace {
lv_obj_t* settingsScreen = nullptr;
lv_obj_t* calibrationScreen = nullptr;
lv_obj_t* updateScreen = nullptr;
lv_obj_t* diagnosticsScreen = nullptr;
lv_obj_t* calibrationRunScreen = nullptr;
lv_obj_t* calibrationChart = nullptr;
lv_chart_series_t* calibrationSeries = nullptr;
lv_obj_t* calibrationCancel = nullptr;
lv_obj_t* calibrationDone = nullptr;
lv_obj_t* calibrationStability = nullptr;
lv_obj_t* mainWarning = nullptr;
lv_obj_t* batteryLevel = nullptr;
lv_obj_t* mainO2Reading = nullptr;
lv_obj_t* mainHeReading = nullptr;
lv_obj_t* mainCoReading = nullptr;
lv_obj_t* mainO2Value = nullptr;
lv_obj_t* mainHeValue = nullptr;
lv_obj_t* mainCoValue = nullptr;
lv_obj_t* largeO2Row = nullptr;
lv_obj_t* largeHeRow = nullptr;
lv_obj_t* largeCoRow = nullptr;
lv_obj_t* largeO2Value = nullptr;
lv_obj_t* largeHeValue = nullptr;
lv_obj_t* largeCoValue = nullptr;
lv_obj_t* largeCoUnit = nullptr;
float calibrationGraphMinimum = NAN;
float calibrationGraphMaximum = NAN;
uint32_t calibrationGraphElapsedMs = UINT32_MAX;
bool calibrationGraphFrozen = false;
sensorsData lastPresentedReadings;
AnalyzerSettings lastPresentedSettings;
const char* calibrationTitleKey = "Calibrating";
const char* calibrationStatusKey = "Settling";
const char* updateStatusKey = "Not connected";
int updateProgress = -1;
bool updateHasNetworks = false;
bool wifiScanComplete = false;

void refreshLanguageText();
void refreshDiagnosticsText();

void copyText(lv_subject_t* subject, const char* text) {
  if (subject == &calibration_run_title_text) calibrationTitleKey = text;
  if (subject == &calibration_stability_text) calibrationStatusKey = text;
  const char* translated = lv_tr(text);
  if (std::strcmp(lv_subject_get_string(subject), translated) != 0) lv_subject_copy_string(subject, translated);
}

void setUpdateStatus(const char* key, int progress = -1) {
  updateStatusKey = key;
  updateProgress = progress;
  if (progress < 0) {
    copyText(&update_status_text, key);
  } else {
    char text[160];
    std::snprintf(text, sizeof(text), lv_tr(key), static_cast<unsigned>(progress));
    copyText(&update_status_text, text);
  }
}

void refreshDiagnosticsText() {
  char log[UiLog::kLogSnapshotSize];
  UiLog::getInstance().copyLogTo(log);
  if (!log[0]) {
    copyText(&diagnostics_log_text, "No log entries");
    return;
  }
  char translated[UI_SUBJECT_STRING_LENGTH] = {};
  size_t used = 0;
  const auto append = [&](const char* text) {
    size_t count = std::min(std::strlen(text), sizeof(translated) - used - 1);
    while (count && (static_cast<unsigned char>(text[count]) & 0xc0) == 0x80) --count;
    std::memcpy(translated + used, text, count);
    used += count;
    translated[used] = '\0';
  };
  char* line = log;
  while (*line && used < sizeof(translated) - 1) {
    char* next = std::strchr(line, '\n');
    if (next) *next++ = '\0';
    char* message = line;
    if (*line == '[') {
      char* timestampEnd = std::strchr(line, ']');
      if (timestampEnd && timestampEnd[1] == ' ') {
        message = timestampEnd + 2;
        const char first = *message;
        *message = '\0';
        append(line);
        *message = first;
      }
    }
    while (*message) {
      const char* wholeMessage = lv_tr(message);
      if (std::strcmp(wholeMessage, message) != 0) {
        append(wholeMessage);
        break;
      }
      char* following = std::strstr(message, "; ");
      if (following) *following = '\0';
      char* invalid = std::strstr(message, " invalid: ");
      if (invalid) {
        *invalid = '\0';
        append(lv_tr(message));
        append(" ");
        append(lv_tr("invalid"));
        append(": ");
        append(lv_tr(invalid + std::strlen(" invalid: ")));
      } else {
        append(lv_tr(message));
      }
      if (!following) break;
      append("; ");
      message = following + 2;
    }
    if (!next) break;
    append("\n");
    line = next;
  }
  copyText(&diagnostics_log_text, translated);
}

void bindClick(lv_obj_t* object, lv_event_cb_t callback) {
  if (!object) {
    log_e("Exported UI object missing");
    return;
  }
  for (uint32_t index = lv_obj_get_event_count(object); index > 0; --index) {
    lv_event_dsc_t* descriptor = lv_obj_get_event_dsc(object, index - 1);
    if (descriptor->filter == LV_EVENT_CLICKED &&
        lv_event_dsc_get_cb(descriptor) != lv_event_free_user_data_cb) {
      lv_obj_remove_event(object, index - 1);
    }
  }
  lv_obj_add_event_cb(object, callback, LV_EVENT_CLICKED, nullptr);
}

void switchReadings(lv_event_t* event) {
  lv_event_stop_bubbling(event);
  lv_screen_load(lv_screen_active() == mainscr ? largescr : mainscr);
  displayManager.resetInactivity();
}

void closeSettings(lv_event_t*) {
  AnalyzerSettings draft = uiSettings();
  const bool valid = readSettings(draft);
  const bool submitted = closeUiSettings(valid ? draft : uiSettings());
  lv_obj_t* previous = settingsScreen;
  settingsScreen = nullptr;
  lv_screen_load(mainscr);
  lv_obj_delete_async(previous);
  if (!valid) messageBox("Invalid settings - restored", NAN);
  else if (!submitted) messageBox("Settings not applied - analyzer busy", NAN);
}

void previewBrightness(lv_event_t*) {
  displayManager.setBrightness(static_cast<uint8_t>(lv_subject_get_int(&settings_brightness)));
}

void setLanguage(uint8_t language) {
  const char* code = language == app::LANGUAGE_BULGARIAN ? "bg" : "en";
  const char* current = lv_translation_get_language();
  if (!current || std::strcmp(current, code) != 0) {
    lv_translation_set_language(code);
    refreshLanguageText();
  }
}

void previewLanguage(lv_event_t* event) {
  const uint32_t selected = lv_dropdown_get_selected(lv_event_get_target_obj(event));
  if (AnalyzerSettings::validLanguage(selected)) setLanguage(static_cast<uint8_t>(selected));
}

void closeCalibration(lv_event_t*) {
  calibrationScreen = nullptr;
  lv_screen_load_anim(mainscr, LV_SCREEN_LOAD_ANIM_NONE, 0, 0, true);
}

void changeStartupCalibration(lv_event_t*) {
  app::Command command;
  command.settings = uiSettings();
  command.settings.calibrateOnStart = lv_subject_get_int(&calibration_on_start) != 0;
  if (!submitAnalyzerCommand(command)) {
    messageBox("Analyzer busy - preference not saved", NAN);
  } else if (command.settings.calibrateOnStart) {
    lv_obj_t* warning = lv_msgbox_create(nullptr);
    lv_obj_set_width(warning, LV_PCT(95));
    lv_obj_t* title = lv_msgbox_add_title(warning, lv_tr("Startup air calibration"));
    lv_label_set_translation_tag(title, "Startup air calibration");
    lv_obj_set_style_text_font(title, font_body, 0);
    lv_obj_set_width(title, 0);
    lv_obj_set_flex_grow(title, 1);
    lv_label_set_long_mode(title, LV_LABEL_LONG_MODE_WRAP);
    lv_msgbox_add_close_button(warning);
    const char* warningKey = "Make sure the unit is flushed with air and there is no stale gas inside when starting";
    lv_obj_t* text = lv_msgbox_add_text(warning, lv_tr(warningKey));
    lv_label_set_translation_tag(text, warningKey);
    lv_obj_set_style_text_font(text, font_body, 0);
  }
  lv_subject_set_int(&calibration_on_start, uiSettings().calibrateOnStart);
}

void closeUpdates(lv_event_t*) {
  updateScreen = nullptr;
  lv_screen_load_anim(settingsScreen ? settingsScreen : mainscr, LV_SCREEN_LOAD_ANIM_NONE, 0, 0, true);
}

void closeDiagnostics(lv_event_t*) {
  diagnosticsScreen = nullptr;
  lv_screen_load_anim(calibrationScreen ? calibrationScreen : mainscr, LV_SCREEN_LOAD_ANIM_NONE, 0, 0, true);
}

void finishCalibrationRun(lv_event_t*) {
  lv_obj_t* previous = calibrationRunScreen;
  calibrationRunScreen = nullptr;
  calibrationChart = nullptr;
  calibrationSeries = nullptr;
  calibrationCancel = nullptr;
  calibrationDone = nullptr;
  calibrationStability = nullptr;
  calibrationGraphFrozen = false;
  lv_screen_load(calibrationScreen ? calibrationScreen : mainscr);
  lv_obj_delete(previous);
}

void cancelCalibrationRun(lv_event_t* event) {
  lv_obj_t* button = lv_event_get_target_obj(event);
  lv_obj_add_state(button, LV_STATE_DISABLED);
  copyText(&calibration_stability_text, "Cancelling");
  if (!cancelAnalyzerCalibration()) {
    lv_obj_remove_state(button, LV_STATE_DISABLED);
    copyText(&calibration_stability_text, "Cancel failed");
  }
}

void openCalibrationRun(app::CommandType type, const char* title) {
  app::Command command;
  command.type = type;
  if (!submitAnalyzerCommand(command)) {
    messageBox("Analyzer busy - try again", NAN);
    return;
  }
  copyText(&calibration_run_title_text, title);
  copyText(&calibration_current_text, "-- mV");
  copyText(&calibration_elapsed_text, "0.0 s");
  copyText(&calibration_stability_text, "Settling");
  calibrationRunScreen = calibration_run_create();
  if (!calibrationRunScreen) {
    cancelAnalyzerCalibration();
    messageBox("Could not open calibration graph", NAN);
    return;
  }
  calibrationChart = lv_obj_find_by_name(calibrationRunScreen, "calibration_graph");
  calibrationSeries = calibrationChart ? lv_chart_get_series_next(calibrationChart, nullptr) : nullptr;
  calibrationCancel = lv_obj_find_by_name(calibrationRunScreen, "calibration_cancel");
  calibrationDone = lv_obj_find_by_name(calibrationRunScreen, "calibration_done");
  calibrationStability = lv_obj_find_by_name(calibrationRunScreen, "calibration_stability");
  if (calibrationStability) {
    lv_obj_set_style_text_color(calibrationStability, COLOR_DANGER, LV_PART_MAIN | LV_STATE_USER_1);
    lv_obj_remove_state(calibrationStability, LV_STATE_USER_1);
  }
  calibrationGraphMinimum = NAN;
  calibrationGraphMaximum = NAN;
  calibrationGraphElapsedMs = UINT32_MAX;
  calibrationGraphFrozen = false;
  bindClick(calibrationCancel, cancelCalibrationRun);
  bindClick(calibrationDone, finishCalibrationRun);
  lv_screen_load(calibrationRunScreen);
}

void startAirCalibration(lv_event_t*) {
  openCalibrationRun(app::CommandType::CalibrateAir, "Air calibration");
}

void startPureCalibration(lv_event_t*) {
  openCalibrationRun(app::CommandType::CalibratePure, "Pure O2 calibration");
}

void startHeliumCalibration(lv_event_t*) {
  openCalibrationRun(app::CommandType::CalibrateHe, "Helium calibration");
}

void clearPureCalibration(lv_event_t*) {
  app::Command command;
  command.type = app::CommandType::ClearPure;
  if (!submitAnalyzerCommand(command)) messageBox("Analyzer busy - try again", NAN);
}

void openSettings(lv_event_t*) {
  if (settingsScreen) return;
  openUiSettings();
  settingsScreen = settings_create();
  if (!settingsScreen) {
    closeUiSettings(uiSettings());
    messageBox("Could not open settings", NAN);
    return;
  }
  bindClick(lv_obj_find_by_name(settingsScreen, "settings_back"), closeSettings);
  bindClick(lv_obj_find_by_name(settingsScreen, "open_updates"), openUpdates);
  lv_obj_t* brightness = lv_obj_find_by_name(settingsScreen, "brightness");
  if (brightness) lv_obj_add_event_cb(brightness, previewBrightness, LV_EVENT_VALUE_CHANGED, nullptr);
  lv_obj_t* language = lv_obj_find_by_name(settingsScreen, "language");
  if (language) {
    lv_obj_add_event_cb(language, previewLanguage, LV_EVENT_VALUE_CHANGED, nullptr);
  }
  refreshLanguageText();
  lv_screen_load(settingsScreen);
}

ChannelState percentageState(float value, ChannelState state) {
  return state == ChannelState::Valid && (!std::isfinite(value) || value < 0)
      ? ChannelState::Invalid : state;
}

void setReading(lv_subject_t* subject, float value, ChannelState state, const char* format) {
  char text[48];
  formatValue(text, sizeof(text), value, state, format);
  copyText(subject, text);
}

void setUnit(lv_obj_t* value, const char* unit, bool visible) {
  lv_span_t* span = value ? lv_spangroup_get_child(value, 1) : nullptr;
  if (span) lv_spangroup_set_span_text_static(value, span, visible ? unit : "");
}

void setVisible(lv_obj_t* object, bool visible) {
  if (object) lv_obj_set_flag(object, LV_OBJ_FLAG_HIDDEN, !visible);
}

void setRaw(lv_subject_t* subject, float value, ChannelState state) {
  const bool showRaw = std::isfinite(value) && state != ChannelState::Stale &&
                       state != ChannelState::Disabled && state != ChannelState::Unavailable;
  setReading(subject, value, showRaw ? ChannelState::Valid : state, "%.1f mV");
}

void finishFirmwareUpdateOperation() {
  finishFirmwareUpdate();
  setNetworkOperationActive(false);
}

void scanWifi(lv_event_t*) {
  if (firmwareUpdateBusy()) {
    messageBox("Network operation in progress", NAN);
    return;
  }
  if (!lv_obj_find_by_name(lv_screen_active(), "wifi_names")) return;
  if (!startWifiScan()) {
    messageBox("Could not start Wi-Fi scan", NAN);
    return;
  }
  setNetworkOperationActive(true);
  setUpdateStatus("Scanning Wi-Fi...");
  lv_subject_set_int(&update_can_install, 0);
  log_i("Listing WiFi networks");
}

void updateFirmware(lv_event_t*) {
  if (firmwareUpdateBusy()) {
    messageBox("Network operation in progress", NAN);
    return;
  }
  lv_obj_t* screen = lv_screen_active();
  lv_obj_t* wifiNames = lv_obj_find_by_name(screen, "wifi_names");
  lv_obj_t* wifiPassword = lv_obj_find_by_name(screen, "wifi_password");
  if (!wifiNames || !wifiPassword || lv_dropdown_get_option_count(wifiNames) == 0) {
    messageBox("Select a Wi-Fi network first", NAN);
    return;
  }
  char selectedSSID[FIRMWARE_UPDATE_MAX_SSID_LENGTH + 1];
  lv_dropdown_get_selected_str(wifiNames, selectedSSID, sizeof(selectedSSID));
  if (!startFirmwareUpdate(selectedSSID, lv_textarea_get_text(wifiPassword))) {
    messageBox("Could not start firmware update", NAN);
    return;
  }
  log_i("Updating firmware");
  log_i("Free heap before OTA: %d", ESP.getFreeHeap());
  log_i("Selected SSID: %s", selectedSSID);
  setNetworkOperationActive(true);
  lv_subject_set_int(&update_can_install, 0);
  setUpdateStatus("Connecting to Wi-Fi...");
}

void refreshLanguageText() {
  presentReadings(lastPresentedReadings, lastPresentedSettings);
  copyText(&calibration_run_title_text, calibrationTitleKey);
  copyText(&calibration_stability_text, calibrationStatusKey);
  setUpdateStatus(updateStatusKey, updateProgress);
  if (settingsScreen) {
    lv_obj_t* sleep = lv_obj_find_by_name(settingsScreen, "sleep_timeout");
    if (sleep) {
      const uint32_t selected = lv_dropdown_get_selected(sleep);
      lv_dropdown_set_options(sleep, lv_tr("sleep_options"));
      lv_dropdown_set_selected(sleep, selected);
    }
  }
  if (updateScreen) {
    lv_obj_t* password = lv_obj_find_by_name(updateScreen, "wifi_password");
    if (password) lv_textarea_set_placeholder_text(password, lv_tr("Wi-Fi password"));
    lv_obj_t* networks = lv_obj_find_by_name(updateScreen, "wifi_names");
    if (networks && !updateHasNetworks) {
      lv_dropdown_set_text(networks, lv_tr(wifiScanComplete ? "No networks found" : "No networks"));
    }
  }
  if (diagnosticsScreen) refreshDiagnosticsText();
}
}

void init() {
  lvgl_ui_project_set_target(LVGL_UI_PROJECT_TARGET_TARGET1);
  lvgl_ui_project_init("");
  mainWarning = lv_obj_find_by_name(mainscr, "open_diagnostics");
  batteryLevel = lv_obj_find_by_name(mainscr, "battery_level");
  mainO2Reading = lv_obj_find_by_name(mainscr, "main_o2_reading");
  mainO2Value = mainO2Reading ? lv_obj_find_by_name(mainO2Reading, "primary_value") : nullptr;
  mainHeReading = lv_obj_find_by_name(mainscr, "main_he_reading");
  mainHeValue = mainHeReading ? lv_obj_find_by_name(mainHeReading, "primary_value") : nullptr;
  mainCoReading = lv_obj_find_by_name(mainscr, "main_co_reading");
  mainCoValue = mainCoReading ? lv_obj_find_by_name(mainCoReading, "primary_value") : nullptr;
  largeO2Row = lv_obj_find_by_name(largescr, "large_o2_row");
  largeHeRow = lv_obj_find_by_name(largescr, "large_he_row");
  largeCoRow = lv_obj_find_by_name(largescr, "large_status");
  largeO2Value = lv_obj_find_by_name(largescr, "large_o2_value");
  largeHeValue = lv_obj_find_by_name(largescr, "large_he_value");
  largeCoValue = lv_obj_find_by_name(largescr, "large_co_value");
  largeCoUnit = lv_obj_find_by_name(largescr, "large_co_unit");
  if (mainCoValue) lv_obj_set_style_text_color(mainCoValue, COLOR_DANGER, LV_PART_MAIN | LV_STATE_USER_1);
  if (largeCoValue) lv_obj_set_style_text_color(largeCoValue, COLOR_DANGER, LV_PART_MAIN | LV_STATE_USER_1);
  bindClick(mainscr, switchReadings);
  bindClick(largescr, switchReadings);
  bindClick(mainWarning, openLogs);
  bindClick(lv_obj_find_by_name(mainscr, "open_settings"), openSettings);
  bindClick(lv_obj_find_by_name(mainscr, "open_calibration"), openCalibration);
  presentReadings(sensorsData{}, AnalyzerSettings{});
  presentBattery(NAN);
  lv_screen_load(mainscr);
}

void syncSettings(const AnalyzerSettings& settings) {
  syncActionSettings(settings);
  setLanguage(settings.language);
  lv_subject_set_int(&settings_language_index, settings.language);
  lv_subject_set_int(&settings_o2_enabled, settings.o2Enabled);
  lv_subject_set_int(&settings_he_enabled, settings.heEnabled);
  lv_subject_set_int(&settings_co_enabled, settings.coEnabled);
  lv_subject_set_int(&settings_co_correction_index, coCorrectionSelection(settings.coCorrectionPpm));
  lv_subject_set_int(&settings_po2_bottom_index, po2Selection(settings.po2Bottom));
  lv_subject_set_int(&settings_po2_deco_index, po2Selection(settings.po2Deco));
  lv_subject_set_int(&settings_brightness, settings.brightness);
  lv_subject_set_int(&settings_sleep_index, app::sleepSelectionForMinutes(settings.sleepMinutes));
}

void syncActionSettings(const AnalyzerSettings& settings) {
  lv_subject_set_int(&calibration_on_start, settings.calibrateOnStart);
}

void openCalibration(lv_event_t*) {
  if (calibrationScreen) return;
  syncActionSettings(uiSettings());
  calibrationScreen = calibration_create();
  if (!calibrationScreen) {
    messageBox("Could not open calibration", NAN);
    return;
  }
  bindClick(lv_obj_find_by_name(calibrationScreen, "calibration_back"), closeCalibration);
  bindClick(lv_obj_find_by_name(calibrationScreen, "calibrate_air"), startAirCalibration);
  bindClick(lv_obj_find_by_name(calibrationScreen, "calibrate_o2"), startPureCalibration);
  bindClick(lv_obj_find_by_name(calibrationScreen, "calibrate_he"), startHeliumCalibration);
  bindClick(lv_obj_find_by_name(calibrationScreen, "clear_o2"), clearPureCalibration);
  bindClick(lv_obj_find_by_name(calibrationScreen, "open_diagnostics"), openLogs);
  lv_obj_t* startup = lv_obj_find_by_name(calibrationScreen, "startup_calibration");
  if (startup) lv_obj_add_event_cb(startup, changeStartupCalibration, LV_EVENT_VALUE_CHANGED, nullptr);
  lv_screen_load(calibrationScreen);
}

void openUpdates(lv_event_t*) {
  if (updateScreen) return;
  lv_subject_set_int(&update_can_install, 0);
  lv_subject_set_int(&update_keyboard_visible, 0);
  copyText(&firmware_version_text, FIRMWARE_VERSION_TEXT);
  setUpdateStatus("Not connected");
  updateHasNetworks = false;
  wifiScanComplete = false;
  updateScreen = firmware_update_create();
  if (!updateScreen) {
    messageBox("Could not open firmware update", NAN);
    return;
  }
  bindClick(lv_obj_find_by_name(updateScreen, "update_back"), closeUpdates);
  bindClick(lv_obj_find_by_name(updateScreen, "scan_wifi"), scanWifi);
  bindClick(lv_obj_find_by_name(updateScreen, "install_firmware"), updateFirmware);
  lv_obj_t* networks = lv_obj_find_by_name(updateScreen, "wifi_names");
  if (networks) lv_dropdown_clear_options(networks);
  refreshLanguageText();
  lv_screen_load(updateScreen);
}

void openLogs(lv_event_t*) {
  if (diagnosticsScreen) return;
  refreshDiagnosticsText();
  diagnosticsScreen = diagnostics_create();
  if (!diagnosticsScreen) {
    messageBox("Could not open diagnostics", NAN);
    return;
  }
  bindClick(lv_obj_find_by_name(diagnosticsScreen, "diagnostics_back"), closeDiagnostics);
  lv_screen_load(diagnosticsScreen);
}

bool readSettings(AnalyzerSettings& settings) {
  AnalyzerSettings candidate = settings;
  candidate.o2Enabled = lv_subject_get_int(&settings_o2_enabled) != 0;
  candidate.heEnabled = lv_subject_get_int(&settings_he_enabled) != 0;
  candidate.coEnabled = lv_subject_get_int(&settings_co_enabled) != 0;
  const int selectedLanguage = lv_subject_get_int(&settings_language_index);
  if (!AnalyzerSettings::validLanguage(selectedLanguage)) return false;
  candidate.language = static_cast<uint8_t>(selectedLanguage);
  if (!applySelections(candidate, lv_subject_get_int(&settings_po2_bottom_index),
                       lv_subject_get_int(&settings_po2_deco_index),
                       lv_subject_get_int(&settings_brightness), lv_subject_get_int(&settings_sleep_index),
                       lv_subject_get_int(&settings_co_correction_index))) return false;
  settings = candidate;
  return true;
}

void presentReadings(const sensorsData& data, const AnalyzerSettings& settings) {
  lastPresentedReadings = data;
  lastPresentedSettings = settings;
  const ChannelState oxygen = percentageState(data.O2Level.percentage, data.o2State);
  const ChannelState helium = percentageState(data.HeLevel.percentage, data.heState);
  setVisible(mainO2Reading, oxygen != ChannelState::Disabled);
  setVisible(mainHeReading, helium != ChannelState::Disabled);
  setVisible(mainCoReading, data.coState != ChannelState::Disabled);
  setVisible(largeO2Row, oxygen != ChannelState::Disabled);
  setVisible(largeHeRow, helium != ChannelState::Disabled);
  setVisible(largeCoRow, data.coState != ChannelState::Disabled);
  setReading(&main_o2_text, data.O2Level.percentage, oxygen, "%.1f");
  setReading(&main_he_text, data.HeLevel.percentage, helium, "%.1f");
  int co;
  const bool validCo = data.coState == ChannelState::Valid && conversions::toInt(data.CoLevel.ppm, co);
  setReading(&main_co_text, validCo ? static_cast<float>(co) : NAN, data.coState, "%.0f");
  setUnit(mainO2Value, "%", oxygen == ChannelState::Valid);
  setUnit(mainHeValue, "%", helium == ChannelState::Valid);
  setUnit(mainCoValue, "ppm", validCo);
  setUnit(largeO2Value, "%", oxygen == ChannelState::Valid);
  setUnit(largeHeValue, "%", helium == ChannelState::Valid);
  setVisible(largeCoUnit, validCo);
  if (mainO2Value) lv_obj_set_style_text_font(mainO2Value, oxygen == ChannelState::Valid ? font_h2 : font_h4, 0);
  if (mainHeValue) lv_obj_set_style_text_font(mainHeValue, helium == ChannelState::Valid ? font_h2 : font_h4, 0);
  if (mainCoValue) lv_obj_set_style_text_font(mainCoValue, validCo ? font_h2 : font_h4, 0);
  setRaw(&main_o2_mv_text, data.O2Level.millivolts, data.o2State);
  setRaw(&main_he_mv_text, data.HeLevel.millivolts, data.heState);
  setRaw(&main_co_mv_text, data.CoLevel.millivolts, data.coState);
  setReading(&main_he_temperature_text, data.HeTemperature, data.temperatureState, "%.1f \xC2\xB0" "C");
  char text[32];
  formatMod(text, sizeof(text), "B", settings.po2Bottom, data.O2Level.percentage, oxygen);
  copyText(&main_mod_bottom_text, text);
  formatMod(text, sizeof(text), "D", settings.po2Deco, data.O2Level.percentage, oxygen);
  copyText(&main_mod_deco_text, text);
  if (largeO2Value) lv_obj_set_style_text_font(largeO2Value, oxygen == ChannelState::Valid ? font_h1 : font_body, 0);
  if (largeHeValue) lv_obj_set_style_text_font(largeHeValue, helium == ChannelState::Valid ? font_h1 : font_body, 0);
}

void presentBattery(float voltage) {
  char text[24];
  const int level = estimatedBatteryLevel(voltage);
  if (level >= 0) std::snprintf(text, sizeof(text), "%.2f V", static_cast<double>(voltage));
  else std::snprintf(text, sizeof(text), "-- V");
  copyText(&main_battery_text, text);
  if (batteryLevel) {
    lv_bar_set_value(batteryLevel, level < 0 ? 0 : level, LV_ANIM_OFF);
    const uint32_t color = level < 0 ? 0x808080 : level < 20 ? 0xFF3B30 : level < 40 ? 0xFF9500 : 0x34C759;
    lv_obj_set_style_bg_color(batteryLevel, lv_color_hex(color), LV_PART_INDICATOR);
    lv_obj_set_style_border_color(batteryLevel, lv_color_hex(level < 0 ? 0x808080 : color), LV_PART_MAIN);
  }
}

void presentStatus(const sensorsData& data, bool, bool) {
  int displayedCo;
  const bool coWarning = data.coState == ChannelState::Valid &&
                         conversions::toInt(data.CoLevel.ppm, displayedCo) && displayedCo > 0;
  const UiLogLevel level = UiLog::getInstance().getLevel();
  if (mainWarning) lv_obj_set_flag(mainWarning, LV_OBJ_FLAG_HIDDEN, level == UiLogLevel::None);
  if (mainCoValue) {
    if (coWarning) lv_obj_add_state(mainCoValue, LV_STATE_USER_1);
    else lv_obj_remove_state(mainCoValue, LV_STATE_USER_1);
  }
  if (largeCoValue) {
    if (coWarning) lv_obj_add_state(largeCoValue, LV_STATE_USER_1);
    else lv_obj_remove_state(largeCoValue, LV_STATE_USER_1);
  }
}

void presentCalibration(const app::Result& result) {
  if (!calibrationRunScreen || calibrationGraphFrozen || result.calibrationPhase == app::CalibrationPhase::None) return;
  char text[32];
  if (std::isfinite(result.calibrationMillivolts)) {
    std::snprintf(text, sizeof(text), "%.2f mV", static_cast<double>(result.calibrationMillivolts));
  } else {
    std::snprintf(text, sizeof(text), "-- mV");
  }
  copyText(&calibration_current_text, text);
  std::snprintf(text, sizeof(text), "%.1f s", static_cast<double>(result.calibrationElapsedMs) / 1000.0);
  copyText(&calibration_elapsed_text, text);

  if (calibrationChart && calibrationSeries && std::isfinite(result.calibrationMillivolts) &&
      result.calibrationElapsedMs != calibrationGraphElapsedMs) {
    calibrationGraphElapsedMs = result.calibrationElapsedMs;
    calibrationGraphMinimum = std::isfinite(calibrationGraphMinimum)
        ? std::min(calibrationGraphMinimum, result.calibrationMillivolts) : result.calibrationMillivolts;
    calibrationGraphMaximum = std::isfinite(calibrationGraphMaximum)
        ? std::max(calibrationGraphMaximum, result.calibrationMillivolts) : result.calibrationMillivolts;
    const float margin = std::max(0.5f, (calibrationGraphMaximum - calibrationGraphMinimum) * 0.2f);
    lv_chart_set_axis_range(calibrationChart, LV_CHART_AXIS_PRIMARY_Y,
                            static_cast<int32_t>(std::floor((calibrationGraphMinimum - margin) * 100)),
                            static_cast<int32_t>(std::ceil((calibrationGraphMaximum + margin) * 100)));
    lv_chart_set_next_value(calibrationChart, calibrationSeries,
                            static_cast<int32_t>(std::lround(result.calibrationMillivolts * 100)));
  }

  const char* status = "Settling";
  const bool failed = result.calibrationPhase == app::CalibrationPhase::Failed;
  const bool outOfRange = failed && result.failure == app::Failure::Invalid;
  switch (result.calibrationPhase) {
    case app::CalibrationPhase::Stable: status = "Stable"; break;
    case app::CalibrationPhase::Saved: status = "Saved"; break;
    case app::CalibrationPhase::Cancelled: status = "Cancelled"; break;
    case app::CalibrationPhase::Failed:
      if (result.failure == app::Failure::Storage) status = "Save failed";
      else if (outOfRange) status = "Invalid value range. Check gas or sensor";
      else status = "Unstable - not saved";
      break;
    default: break;
  }
  copyText(&calibration_stability_text, status);
  if (calibrationStability) {
    if (failed) lv_obj_add_state(calibrationStability, LV_STATE_USER_1);
    else lv_obj_remove_state(calibrationStability, LV_STATE_USER_1);
  }
  if (result.complete) {
    calibrationGraphFrozen = true;
    if (calibrationCancel) lv_obj_add_flag(calibrationCancel, LV_OBJ_FLAG_HIDDEN);
    if (calibrationDone) lv_obj_remove_flag(calibrationDone, LV_OBJ_FLAG_HIDDEN);
  }
}

void serviceFirmwareUpdate() {
  FirmwareUpdateEvent event;
  if (!pollFirmwareUpdateEvent(event)) return;

  switch (event.type) {
    case FirmwareUpdateEventType::ScanComplete: {
      updateHasNetworks = event.networkCount > 0;
      wifiScanComplete = true;
      lv_obj_t* wifiNames = lv_obj_find_by_name(lv_screen_active(), "wifi_names");
      if (wifiNames) {
        lv_dropdown_clear_options(wifiNames);
        for (uint8_t index = 0; index < event.networkCount; ++index) {
          log_i("Found WiFi network: %s", event.networks[index]);
          lv_dropdown_add_option(wifiNames, event.networks[index], LV_DROPDOWN_POS_LAST);
        }
        lv_dropdown_set_text(wifiNames, event.networkCount ? nullptr : lv_tr("No networks found"));
      }
      lv_subject_set_int(&update_network_index, 0);
      lv_subject_set_int(&update_can_install, event.networkCount > 0);
      setUpdateStatus(
               event.networkCount ? "Select a network and enter its password" : "No networks found");
      finishFirmwareUpdateOperation();
      break;
    }
    case FirmwareUpdateEventType::TimeSyncStarted:
      setUpdateStatus("Setting device time...");
      break;
    case FirmwareUpdateEventType::DownloadStarted:
      setUpdateStatus("Downloading firmware... 0%");
      break;
    case FirmwareUpdateEventType::DownloadProgress: {
      setUpdateStatus("Downloading... %u%%", event.progress);
      break;
    }
    case FirmwareUpdateEventType::UpdateComplete:
      setUpdateStatus("Update complete - restarting...");
      break;
    case FirmwareUpdateEventType::ConnectionFailed:
      setUpdateStatus("Wi-Fi connection failed");
      lv_subject_set_int(&update_can_install, 1);
      finishFirmwareUpdateOperation();
      messageBox("Wi-Fi connection failed", NAN);
      break;
    case FirmwareUpdateEventType::TimeSyncFailed:
      setUpdateStatus("Could not set time - update cancelled");
      lv_subject_set_int(&update_can_install, 1);
      finishFirmwareUpdateOperation();
      messageBox("Could not set device time", NAN);
      break;
    case FirmwareUpdateEventType::SecureConnectionFailed:
      setUpdateStatus("Secure connection failed");
      lv_subject_set_int(&update_can_install, 1);
      finishFirmwareUpdateOperation();
      messageBox("Secure connection failed", NAN);
      break;
    case FirmwareUpdateEventType::UpdateFailed:
      setUpdateStatus("Firmware update failed");
      lv_subject_set_int(&update_can_install, 1);
      finishFirmwareUpdateOperation();
      messageBox("Firmware update failed", NAN);
      break;
  }
}
}
