vldgeorgiev/scuba-gas-analyzer/lvgl-ui-project/lvgl_ui_project_gen.c

/**
 * @file lvgl_ui_project_gen.c
 */

/*********************
 *      INCLUDES
 *********************/

#include "lvgl_ui_project_gen.h"

#if defined(LV_USE_XML) && LV_USE_XML
#endif /* LV_USE_XML */

/*********************
 *      DEFINES
 *********************/

/**********************
 *      TYPEDEFS
 **********************/

/**********************
 *  STATIC PROTOTYPES
 **********************/

static void check_font(lv_font_t ** font, const char * name);

/**********************
 *  STATIC VARIABLES
 **********************/

static uint32_t lvgl_ui_project_target = LVGL_UI_PROJECT_TARGET_ALL;

/*----------------
 * Translations
 *----------------*/

#ifndef LV_EDITOR_PREVIEW
    static const char * translation_languages[] = {"en", "bg", NULL};
    static const char * translation_tags[] = {"settings_language", "settings_co_correction", "settings_po2_bottom", "settings_po2_deco", "settings_brightness", "settings_sleep", "settings_firmware_update", "calibration_title", "calibration_on_start", "calibration_air", "calibration_clear_o2", "calibration_cancel", "calibration_done", "diagnostics_title", "update_install", "Off", "Invalid", "Stale", "Warming", "Unavailable", "Invalid settings - restored", "Settings not applied - analyzer busy", "Analyzer busy - preference not saved", "Startup air calibration", "Make sure the unit is flushed with air and there is no stale gas inside when starting", "Cancelling", "Cancel failed", "Analyzer busy - try again", "Calibrating", "Settling", "Stable", "Saved", "Cancelled", "Save failed", "Invalid value range. Check gas or sensor", "Unstable - not saved", "Could not open calibration graph", "Air calibration", "Pure O2 calibration", "Helium calibration", "Could not open settings", "Could not open calibration", "Network operation in progress", "Could not start Wi-Fi scan", "Scanning Wi-Fi...", "Select a Wi-Fi network first", "Could not start firmware update", "Connecting to Wi-Fi...", "Not connected", "Could not open firmware update", "No log entries", "Could not open diagnostics", "No networks", "No networks found", "Select a network and enter its password", "Setting device time...", "Downloading firmware... 0%", "Downloading... %u%%", "Update complete - restarting...", "Wi-Fi connection failed", "Could not set time - update cancelled", "Could not set device time", "Secure connection failed", "Firmware update failed", "Wi-Fi password", "sleep_options", "Invalid settings or calibration", "Settings could not be saved", "Calibration read failed", "Invalid saved settings - defaults loaded", "Analyzer is preparing for sleep", "O2 and He calibration required", "O2 calibration required", "He calibration required", "Operation failed", "O2 Air Calibrated", "O2 100% Calibrated", "He 100% Calibrated", "Pure O2 calibration cleared", "Sleep preparation timed out - staying awake", "Sleep preparation timed out; resuming", "Sleep aborted - touch unavailable", "Touch restoration failed", "Analyzer unavailable", "No error", "ADC unavailable", "ADC conversion timed out", "I2C communication failed", "No sensors enabled", "Calibration failed", "Invalid sensor reading", "Unknown error", "He temperature", "invalid", "unavailable", "Input before wake setup", "RTC power setup failed", "Wake pull-up failed", "Wake pull-down failed", "EXT1 wake setup failed", "Wi-Fi shutdown failed", "Button during shutdown", "GPIO hold failed", "Touch not initialized", "Input before panel sleep", "Input after panel sleep", "Touch reset probe failed", "Input after touch reset", "Touch sleep write failed", NULL};
    static const char * translation_texts[] = {
        "Language", "Език", /* settings_language */
        "CO correction", "Корекция CO", /* settings_co_correction */
        "Bottom pO2", "Дънно pO2", /* settings_po2_bottom */
        "Deco pO2", "Деко pO2", /* settings_po2_deco */
        "Brightness", "Яркост", /* settings_brightness */
        "Sleep", "Заспиване", /* settings_sleep */
        "Firmware update", "Обновяване", /* settings_firmware_update */
        "Calibration", "Калибриране", /* calibration_title */
        "Calibrate air on start", "Въздух при старт", /* calibration_on_start */
        "Air (20.9%)", "Въздух (20.9%)", /* calibration_air */
        "Clear O2", "Изтр. O2", /* calibration_clear_o2 */
        "Cancel", "Отказ", /* calibration_cancel */
        "Done", "Готово", /* calibration_done */
        "Diagnostics", "Диагностика", /* diagnostics_title */
        "Install firmware", "Инсталиране", /* update_install */
        "Off", "Изкл.", /* Off */
        "Invalid", "Невалидно", /* Invalid */
        "Stale", "Стари данни", /* Stale */
        "Warming", "Загрява", /* Warming */
        "Unavailable", "Няма данни", /* Unavailable */
        "Invalid settings - restored", "Невалидни настройки. Без промяна.", /* Invalid settings - restored */
        "Settings not applied - analyzer busy", "Уредът е зает. Без промяна.", /* Settings not applied - analyzer busy */
        "Analyzer busy - preference not saved", "Уредът е зает. Няма запис.", /* Analyzer busy - preference not saved */
        "Startup air calibration", "Калибр. въздух при старт", /* Startup air calibration */
        "Make sure the unit is flushed with air and there is no stale gas inside when starting", "Преди включване продухайте уреда с въздух, за да няма остатъчен газ.", /* Make sure the unit is flushed with air and there is no stale gas inside when starting */
        "Cancelling", "Отменяне", /* Cancelling */
        "Cancel failed", "Неуспешна отмяна", /* Cancel failed */
        "Analyzer busy - try again", "Уредът е зает - опитайте отново", /* Analyzer busy - try again */
        "Calibrating", "Калибриране", /* Calibrating */
        "Settling", "Изчакване", /* Settling */
        "Stable", "Стабилно", /* Stable */
        "Saved", "Записано", /* Saved */
        "Cancelled", "Отменено", /* Cancelled */
        "Save failed", "Неуспешен запис", /* Save failed */
        "Invalid value range. Check gas or sensor", "Невалидна стойност. Проверете газа или сензора", /* Invalid value range. Check gas or sensor */
        "Unstable - not saved", "Нестабилно. Няма запис.", /* Unstable - not saved */
        "Could not open calibration graph", "Графиката не се отваря", /* Could not open calibration graph */
        "Air calibration", "Калибриране с въздух", /* Air calibration */
        "Pure O2 calibration", "Калибриране с чист O2", /* Pure O2 calibration */
        "Helium calibration", "Калибриране с хелий", /* Helium calibration */
        "Could not open settings", "Настройките не се отварят", /* Could not open settings */
        "Could not open calibration", "Калибрирането не се отваря", /* Could not open calibration */
        "Network operation in progress", "Мрежова операция в ход", /* Network operation in progress */
        "Could not start Wi-Fi scan", "Грешка при търсене на Wi-Fi", /* Could not start Wi-Fi scan */
        "Scanning Wi-Fi...", "Търсене на Wi-Fi...", /* Scanning Wi-Fi... */
        "Select a Wi-Fi network first", "Първо изберете Wi-Fi мрежа", /* Select a Wi-Fi network first */
        "Could not start firmware update", "Обновяването не стартира", /* Could not start firmware update */
        "Connecting to Wi-Fi...", "Свързване с Wi-Fi...", /* Connecting to Wi-Fi... */
        "Not connected", "Няма връзка", /* Not connected */
        "Could not open firmware update", "Обновяването не се отваря", /* Could not open firmware update */
        "No log entries", "Няма записи", /* No log entries */
        "Could not open diagnostics", "Диагностиката не се отваря", /* Could not open diagnostics */
        "No networks", "Няма мрежи", /* No networks */
        "No networks found", "Няма намерени мрежи", /* No networks found */
        "Select a network and enter its password", "Изберете мрежа и въведете паролата", /* Select a network and enter its password */
        "Setting device time...", "Сверяване на часа...", /* Setting device time... */
        "Downloading firmware... 0%", "Изтегляне... 0%", /* Downloading firmware... 0% */
        "Downloading... %u%%", "Изтегляне... %u%%", /* Downloading... %u%% */
        "Update complete - restarting...", "Обновено. Рестартиране...", /* Update complete - restarting... */
        "Wi-Fi connection failed", "Неуспешна Wi-Fi връзка", /* Wi-Fi connection failed */
        "Could not set time - update cancelled", "Часът не е сверен. Обновяването е отменено.", /* Could not set time - update cancelled */
        "Could not set device time", "Часът не може да се свери", /* Could not set device time */
        "Secure connection failed", "Неуспешна защитена връзка", /* Secure connection failed */
        "Firmware update failed", "Неуспешно обновяване", /* Firmware update failed */
        "Wi-Fi password", "Wi-Fi парола", /* Wi-Fi password */
        "Never\n1 min\n2 min\n5 min\n10 min\n30 min", "Никога\n1 мин\n2 мин\n5 мин\n10 мин\n30 мин", /* sleep_options */
        "Invalid settings or calibration", "Невалидни настройки или калибриране", /* Invalid settings or calibration */
        "Settings could not be saved", "Неуспешен запис на настройки", /* Settings could not be saved */
        "Calibration read failed", "Неуспешно отчитане", /* Calibration read failed */
        "Invalid saved settings - defaults loaded", "Невалидни настройки. Заредени са стандартните.", /* Invalid saved settings - defaults loaded */
        "Analyzer is preparing for sleep", "Подготовка за заспиване", /* Analyzer is preparing for sleep */
        "O2 and He calibration required", "Калибрирайте O2 и He", /* O2 and He calibration required */
        "O2 calibration required", "Калибрирайте O2", /* O2 calibration required */
        "He calibration required", "Калибрирайте He", /* He calibration required */
        "Operation failed", "Неуспешна операция", /* Operation failed */
        "O2 Air Calibrated", "O2: калибриран с въздух", /* O2 Air Calibrated */
        "O2 100% Calibrated", "O2: калибриран (100%)", /* O2 100% Calibrated */
        "He 100% Calibrated", "He: калибриран (100%)", /* He 100% Calibrated */
        "Pure O2 calibration cleared", "Изтрито калибриране с чист O2", /* Pure O2 calibration cleared */
        "Sleep preparation timed out - staying awake", "Изтекло време. Заспиването е отменено.", /* Sleep preparation timed out - staying awake */
        "Sleep preparation timed out; resuming", "Времето изтече. Възобновяване.", /* Sleep preparation timed out; resuming */
        "Sleep aborted - touch unavailable", "Сънят е отменен - сензорният екран не работи", /* Sleep aborted - touch unavailable */
        "Touch restoration failed", "Сензорният екран не е възстановен", /* Touch restoration failed */
        "Analyzer unavailable", "Анализаторът не е достъпен", /* Analyzer unavailable */
        "No error", "Няма грешка", /* No error */
        "ADC unavailable", "ADC не е достъпен", /* ADC unavailable */
        "ADC conversion timed out", "Изтече времето за ADC измерване", /* ADC conversion timed out */
        "I2C communication failed", "Неуспешна I2C връзка", /* I2C communication failed */
        "No sensors enabled", "Няма активни сензори", /* No sensors enabled */
        "Calibration failed", "Неуспешно калибриране", /* Calibration failed */
        "Invalid sensor reading", "Невалидно показание", /* Invalid sensor reading */
        "Unknown error", "Неизвестна грешка", /* Unknown error */
        "He temperature", "Темп. на He", /* He temperature */
        "invalid", "невалидно", /* invalid */
        "unavailable", "няма данни", /* unavailable */
        "Input before wake setup", "Натискане преди настройка за събуждане", /* Input before wake setup */
        "RTC power setup failed", "Неуспешна настройка на RTC захранването", /* RTC power setup failed */
        "Wake pull-up failed", "Неуспешен pull-up за събуждане", /* Wake pull-up failed */
        "Wake pull-down failed", "Неуспешен pull-down за събуждане", /* Wake pull-down failed */
        "EXT1 wake setup failed", "Неуспешна настройка на EXT1 събуждане", /* EXT1 wake setup failed */
        "Wi-Fi shutdown failed", "Wi-Fi не може да се изключи", /* Wi-Fi shutdown failed */
        "Button during shutdown", "Натиснат бутон при изключване", /* Button during shutdown */
        "GPIO hold failed", "Неуспешно задържане на GPIO", /* GPIO hold failed */
        "Touch not initialized", "Сензорният екран не е готов", /* Touch not initialized */
        "Input before panel sleep", "Натискане преди заспиване на дисплея", /* Input before panel sleep */
        "Input after panel sleep", "Натискане след заспиване на дисплея", /* Input after panel sleep */
        "Touch reset probe failed", "Сензорният екран не отговаря", /* Touch reset probe failed */
        "Input after touch reset", "Натискане след нулиране на сензорния екран", /* Input after touch reset */
        "Touch sleep write failed", "Грешка при приспиване на сензорния екран", /* Touch sleep write failed */
    };
#endif

/**********************
 *  GLOBAL VARIABLES
 **********************/

/*--------------------
 *  Permanent screens
 *-------------------*/

lv_obj_t * largescr = NULL;
lv_obj_t * mainscr = NULL;

/*----------------
 * Fonts
 *----------------*/

lv_font_t * font_body_symbols;
extern lv_font_t font_body_symbols_data;
lv_font_t * font_control;
extern lv_font_t font_control_data;
lv_font_t * font_body;
extern lv_font_t font_body_data;
lv_font_t * font_h5;
extern lv_font_t font_h5_data;
lv_font_t * font_h4;
extern lv_font_t font_h4_data;
lv_font_t * font_h3;
extern lv_font_t font_h3_data;
lv_font_t * font_h2;
extern lv_font_t font_h2_data;
lv_font_t * font_h1;
extern lv_font_t font_h1_data;

/*----------------
 * Images
 *----------------*/

/* Targets: any */
const void * phony_divers_logo = NULL;
extern const void * phony_divers_logo_data;
const void * icon_arrow_down = NULL;
extern const void * icon_arrow_down_data;
const void * icon_arrow_left = NULL;
extern const void * icon_arrow_left_data;
const void * icon_arrow_right = NULL;
extern const void * icon_arrow_right_data;
const void * icon_arrow_up = NULL;
extern const void * icon_arrow_up_data;
const void * icon_battery = NULL;
extern const void * icon_battery_data;
const void * icon_battery_full = NULL;
extern const void * icon_battery_full_data;
const void * icon_bell = NULL;
extern const void * icon_bell_data;
const void * icon_bluetooth = NULL;
extern const void * icon_bluetooth_data;
const void * icon_calendar = NULL;
extern const void * icon_calendar_data;
const void * icon_camera = NULL;
extern const void * icon_camera_data;
const void * icon_check = NULL;
extern const void * icon_check_data;
const void * icon_chevron_down = NULL;
extern const void * icon_chevron_down_data;
const void * icon_chevron_left = NULL;
extern const void * icon_chevron_left_data;
const void * icon_chevron_right = NULL;
extern const void * icon_chevron_right_data;
const void * icon_chevron_up = NULL;
extern const void * icon_chevron_up_data;
const void * icon_clock = NULL;
extern const void * icon_clock_data;
const void * icon_close = NULL;
extern const void * icon_close_data;
const void * icon_download = NULL;
extern const void * icon_download_data;
const void * icon_edit = NULL;
extern const void * icon_edit_data;
const void * icon_heart = NULL;
extern const void * icon_heart_data;
const void * icon_home = NULL;
extern const void * icon_home_data;
const void * icon_info = NULL;
extern const void * icon_info_data;
const void * icon_lock = NULL;
extern const void * icon_lock_data;
const void * icon_mail = NULL;
extern const void * icon_mail_data;
const void * icon_menu = NULL;
extern const void * icon_menu_data;
const void * icon_minus = NULL;
extern const void * icon_minus_data;
const void * icon_moon = NULL;
extern const void * icon_moon_data;
const void * icon_pause = NULL;
extern const void * icon_pause_data;
const void * icon_play = NULL;
extern const void * icon_play_data;
const void * icon_plus = NULL;
extern const void * icon_plus_data;
const void * icon_power = NULL;
extern const void * icon_power_data;
const void * icon_refresh = NULL;
extern const void * icon_refresh_data;
const void * icon_search = NULL;
extern const void * icon_search_data;
const void * icon_settings = NULL;
extern const void * icon_settings_data;
const void * icon_signal = NULL;
extern const void * icon_signal_data;
const void * icon_star = NULL;
extern const void * icon_star_data;
const void * icon_sun = NULL;
extern const void * icon_sun_data;
const void * icon_trash = NULL;
extern const void * icon_trash_data;
const void * icon_unlock = NULL;
extern const void * icon_unlock_data;
const void * icon_upload = NULL;
extern const void * icon_upload_data;
const void * icon_user = NULL;
extern const void * icon_user_data;
const void * icon_volume = NULL;
extern const void * icon_volume_data;
const void * icon_wifi = NULL;
extern const void * icon_wifi_data;
const void * icon_wifi_high = NULL;
extern const void * icon_wifi_high_data;
const void * icon_wifi_low = NULL;
extern const void * icon_wifi_low_data;
const void * icon_wifi_zero = NULL;
extern const void * icon_wifi_zero_data;

/*----------------
 * Global styles
 *----------------*/

lv_style_t style_screen_light;
lv_style_t style_screen_dark;
lv_style_t style_panel_light;
lv_style_t style_panel_dark;
lv_style_t style_text_accent;
lv_style_t style_text_muted;
lv_style_t style_scrollbar;

/*----------------
 * Subjects
 *----------------*/

lv_subject_t subject_theme_dark;
lv_subject_t subject_brightness;
lv_subject_t subject_show_keyboard;
lv_subject_t settings_o2_enabled;
lv_subject_t settings_he_enabled;
lv_subject_t settings_co_enabled;
lv_subject_t settings_language_index;
lv_subject_t settings_co_correction_index;
lv_subject_t settings_po2_bottom_index;
lv_subject_t settings_po2_deco_index;
lv_subject_t settings_brightness;
lv_subject_t settings_sleep_index;
lv_subject_t main_o2_text;
lv_subject_t main_o2_mv_text;
lv_subject_t main_he_text;
lv_subject_t main_he_mv_text;
lv_subject_t main_he_temperature_text;
lv_subject_t main_co_text;
lv_subject_t main_co_mv_text;
lv_subject_t main_mod_bottom_text;
lv_subject_t main_mod_deco_text;
lv_subject_t main_battery_text;
lv_subject_t calibration_on_start;
lv_subject_t calibration_run_title_text;
lv_subject_t calibration_current_text;
lv_subject_t calibration_elapsed_text;
lv_subject_t calibration_stability_text;
lv_subject_t update_network_index;
lv_subject_t update_keyboard_visible;
lv_subject_t update_can_install;
lv_subject_t firmware_version_text;
lv_subject_t update_status_text;
lv_subject_t diagnostics_log_text;

/**********************
 *      MACROS
 **********************/

/**********************
 *   GLOBAL FUNCTIONS
 **********************/

void lvgl_ui_project_init_gen(const char * asset_path)
{
    /* When running from the editor the theme set from the XML should overwrite this */
#if !defined(LV_EDITOR_PREVIEW)
#if LV_USE_THEME_SIMPLE
    lv_display_t * disp = lv_display_get_default();
    lv_theme_t * th = lv_theme_simple_init(disp);
    lv_display_set_theme(disp, th);
#else
    LV_LOG_WARN("Simple theme is selected in project.xml but LV_USE_THEME_SIMPLE is disabled");
#endif
#endif /*LV_EDITOR_PREVIEW*/


    /*----------------
     * Fonts
     *----------------*/

    /* Targets: any */

    #if LVGL_UI_PROJECT_CHECK_COMPILE_TARGET(LVGL_UI_PROJECT_TARGET_ALL)
    if (lvgl_ui_project_check_target(LVGL_UI_PROJECT_TARGET_ALL)) {
        if (!font_body_symbols) {
            /* font_body_symbols */
            /* get font 'font_body_symbols' from a C array */
            font_body_symbols = &font_body_symbols_data;

        }
        if (!font_control) {
            /* font_control */
            /* get font 'font_control' from a C array */
            font_control = &font_control_data;

        }
        if (!font_body) {
            /* font_body */
            /* get font 'font_body' from a C array */
            font_body = &font_body_data;

        }
        if (!font_h5) {
            /* font_h5 */
            /* get font 'font_h5' from a C array */
            font_h5 = &font_h5_data;

        }
        if (!font_h4) {
            /* font_h4 */
            /* get font 'font_h4' from a C array */
            font_h4 = &font_h4_data;

        }
        if (!font_h3) {
            /* font_h3 */
            /* get font 'font_h3' from a C array */
            font_h3 = &font_h3_data;

        }
        if (!font_h2) {
            /* font_h2 */
            /* get font 'font_h2' from a C array */
            font_h2 = &font_h2_data;

        }
        if (!font_h1) {
            /* font_h1 */
            /* get font 'font_h1' from a C array */
            font_h1 = &font_h1_data;

        }
    }
    #endif

    /*----------------
     * Images
     *----------------*/

    /* Targets: any */
    #if LVGL_UI_PROJECT_CHECK_COMPILE_TARGET(LVGL_UI_PROJECT_TARGET_ALL)
    if (lvgl_ui_project_check_target(LVGL_UI_PROJECT_TARGET_ALL)) {
        /* phony_divers_logo */
        if (!phony_divers_logo) {
            phony_divers_logo = &phony_divers_logo_data;
        }
        /* icon_arrow_down */
        if (!icon_arrow_down) {
            icon_arrow_down = &icon_arrow_down_data;
        }
        /* icon_arrow_left */
        if (!icon_arrow_left) {
            icon_arrow_left = &icon_arrow_left_data;
        }
        /* icon_arrow_right */
        if (!icon_arrow_right) {
            icon_arrow_right = &icon_arrow_right_data;
        }
        /* icon_arrow_up */
        if (!icon_arrow_up) {
            icon_arrow_up = &icon_arrow_up_data;
        }
        /* icon_battery */
        if (!icon_battery) {
            icon_battery = &icon_battery_data;
        }
        /* icon_battery_full */
        if (!icon_battery_full) {
            icon_battery_full = &icon_battery_full_data;
        }
        /* icon_bell */
        if (!icon_bell) {
            icon_bell = &icon_bell_data;
        }
        /* icon_bluetooth */
        if (!icon_bluetooth) {
            icon_bluetooth = &icon_bluetooth_data;
        }
        /* icon_calendar */
        if (!icon_calendar) {
            icon_calendar = &icon_calendar_data;
        }
        /* icon_camera */
        if (!icon_camera) {
            icon_camera = &icon_camera_data;
        }
        /* icon_check */
        if (!icon_check) {
            icon_check = &icon_check_data;
        }
        /* icon_chevron_down */
        if (!icon_chevron_down) {
            icon_chevron_down = &icon_chevron_down_data;
        }
        /* icon_chevron_left */
        if (!icon_chevron_left) {
            icon_chevron_left = &icon_chevron_left_data;
        }
        /* icon_chevron_right */
        if (!icon_chevron_right) {
            icon_chevron_right = &icon_chevron_right_data;
        }
        /* icon_chevron_up */
        if (!icon_chevron_up) {
            icon_chevron_up = &icon_chevron_up_data;
        }
        /* icon_clock */
        if (!icon_clock) {
            icon_clock = &icon_clock_data;
        }
        /* icon_close */
        if (!icon_close) {
            icon_close = &icon_close_data;
        }
        /* icon_download */
        if (!icon_download) {
            icon_download = &icon_download_data;
        }
        /* icon_edit */
        if (!icon_edit) {
            icon_edit = &icon_edit_data;
        }
        /* icon_heart */
        if (!icon_heart) {
            icon_heart = &icon_heart_data;
        }
        /* icon_home */
        if (!icon_home) {
            icon_home = &icon_home_data;
        }
        /* icon_info */
        if (!icon_info) {
            icon_info = &icon_info_data;
        }
        /* icon_lock */
        if (!icon_lock) {
            icon_lock = &icon_lock_data;
        }
        /* icon_mail */
        if (!icon_mail) {
            icon_mail = &icon_mail_data;
        }
        /* icon_menu */
        if (!icon_menu) {
            icon_menu = &icon_menu_data;
        }
        /* icon_minus */
        if (!icon_minus) {
            icon_minus = &icon_minus_data;
        }
        /* icon_moon */
        if (!icon_moon) {
            icon_moon = &icon_moon_data;
        }
        /* icon_pause */
        if (!icon_pause) {
            icon_pause = &icon_pause_data;
        }
        /* icon_play */
        if (!icon_play) {
            icon_play = &icon_play_data;
        }
        /* icon_plus */
        if (!icon_plus) {
            icon_plus = &icon_plus_data;
        }
        /* icon_power */
        if (!icon_power) {
            icon_power = &icon_power_data;
        }
        /* icon_refresh */
        if (!icon_refresh) {
            icon_refresh = &icon_refresh_data;
        }
        /* icon_search */
        if (!icon_search) {
            icon_search = &icon_search_data;
        }
        /* icon_settings */
        if (!icon_settings) {
            icon_settings = &icon_settings_data;
        }
        /* icon_signal */
        if (!icon_signal) {
            icon_signal = &icon_signal_data;
        }
        /* icon_star */
        if (!icon_star) {
            icon_star = &icon_star_data;
        }
        /* icon_sun */
        if (!icon_sun) {
            icon_sun = &icon_sun_data;
        }
        /* icon_trash */
        if (!icon_trash) {
            icon_trash = &icon_trash_data;
        }
        /* icon_unlock */
        if (!icon_unlock) {
            icon_unlock = &icon_unlock_data;
        }
        /* icon_upload */
        if (!icon_upload) {
            icon_upload = &icon_upload_data;
        }
        /* icon_user */
        if (!icon_user) {
            icon_user = &icon_user_data;
        }
        /* icon_volume */
        if (!icon_volume) {
            icon_volume = &icon_volume_data;
        }
        /* icon_wifi */
        if (!icon_wifi) {
            icon_wifi = &icon_wifi_data;
        }
        /* icon_wifi_high */
        if (!icon_wifi_high) {
            icon_wifi_high = &icon_wifi_high_data;
        }
        /* icon_wifi_low */
        if (!icon_wifi_low) {
            icon_wifi_low = &icon_wifi_low_data;
        }
        /* icon_wifi_zero */
        if (!icon_wifi_zero) {
            icon_wifi_zero = &icon_wifi_zero_data;
        }
    }
    #endif

    /*----------------
     * Global styles
     *----------------*/

    static bool style_inited = false;

    if (!style_inited) {
        /*Init all styles*/
        lv_style_init(&style_screen_light);
        lv_style_init(&style_screen_dark);
        lv_style_init(&style_panel_light);
        lv_style_init(&style_panel_dark);
        lv_style_init(&style_text_accent);
        lv_style_init(&style_text_muted);
        lv_style_init(&style_scrollbar);

        lv_style_set_bg_color(&style_screen_light, COLOR_LIGHT_BG);
        lv_style_set_bg_opa(&style_screen_light, (255 * 100 / 100));
        lv_style_set_text_color(&style_screen_light, COLOR_LIGHT_TEXT);
        lv_style_set_text_font(&style_screen_light, font_body);
        lv_style_set_bg_color(&style_screen_dark, COLOR_DARK_BG);
        lv_style_set_bg_opa(&style_screen_dark, (255 * 100 / 100));
        lv_style_set_text_color(&style_screen_dark, COLOR_DARK_TEXT);
        lv_style_set_text_font(&style_screen_dark, font_body);
        lv_style_set_bg_color(&style_panel_light, COLOR_LIGHT_PANEL);
        lv_style_set_bg_opa(&style_panel_light, (255 * 100 / 100));
        lv_style_set_border_color(&style_panel_light, COLOR_LIGHT_TEXT);
        lv_style_set_border_opa(&style_panel_light, (255 * 20 / 100));
        lv_style_set_border_width(&style_panel_light, BORDER_WIDTH);
        lv_style_set_text_color(&style_panel_light, COLOR_LIGHT_TEXT);
        lv_style_set_pad_all(&style_panel_light, SPACE_MD);
        lv_style_set_radius(&style_panel_light, RADIUS_DEFAULT);
        lv_style_set_bg_color(&style_panel_dark, COLOR_DARK_PANEL);
        lv_style_set_bg_opa(&style_panel_dark, (255 * 100 / 100));
        lv_style_set_border_color(&style_panel_dark, COLOR_DARK_TEXT);
        lv_style_set_border_opa(&style_panel_dark, (255 * 20 / 100));
        lv_style_set_border_width(&style_panel_dark, BORDER_WIDTH);
        lv_style_set_text_color(&style_panel_dark, COLOR_DARK_TEXT);
        lv_style_set_pad_all(&style_panel_dark, SPACE_MD);
        lv_style_set_radius(&style_panel_dark, RADIUS_DEFAULT);
        lv_style_set_text_color(&style_text_accent, COLOR_ACCENT);
        lv_style_set_text_opa(&style_text_muted, (255 * 60 / 100));
        lv_style_set_width(&style_scrollbar, SPACE_SM);
        lv_style_set_radius(&style_scrollbar, SPACE_SM);
        lv_style_set_bg_color(&style_scrollbar, COLOR_TRACK);
        lv_style_set_bg_opa(&style_scrollbar, (255 * 80 / 100));
        lv_style_set_pad_all(&style_scrollbar, SPACE_SM);

        style_inited = true;
    }

    /*----------------
     * Subjects
     *----------------*/
    lv_subject_init_int(&subject_theme_dark, 0);
    lv_subject_set_min_value_int(&subject_theme_dark, 0);
    lv_subject_set_max_value_int(&subject_theme_dark, 1);
    lv_subject_init_int(&subject_brightness, 60);
    lv_subject_set_min_value_int(&subject_brightness, 0);
    lv_subject_set_max_value_int(&subject_brightness, 100);
    lv_subject_init_int(&subject_show_keyboard, 0);
    lv_subject_init_int(&settings_o2_enabled, 1);
    lv_subject_set_min_value_int(&settings_o2_enabled, 0);
    lv_subject_set_max_value_int(&settings_o2_enabled, 1);
    lv_subject_init_int(&settings_he_enabled, 1);
    lv_subject_set_min_value_int(&settings_he_enabled, 0);
    lv_subject_set_max_value_int(&settings_he_enabled, 1);
    lv_subject_init_int(&settings_co_enabled, 1);
    lv_subject_set_min_value_int(&settings_co_enabled, 0);
    lv_subject_set_max_value_int(&settings_co_enabled, 1);
    lv_subject_init_int(&settings_language_index, 0);
    lv_subject_set_min_value_int(&settings_language_index, 0);
    lv_subject_set_max_value_int(&settings_language_index, 1);
    lv_subject_init_int(&settings_co_correction_index, 2);
    lv_subject_set_min_value_int(&settings_co_correction_index, 0);
    lv_subject_set_max_value_int(&settings_co_correction_index, 7);
    lv_subject_init_int(&settings_po2_bottom_index, 4);
    lv_subject_set_min_value_int(&settings_po2_bottom_index, 0);
    lv_subject_set_max_value_int(&settings_po2_bottom_index, 6);
    lv_subject_init_int(&settings_po2_deco_index, 6);
    lv_subject_set_min_value_int(&settings_po2_deco_index, 0);
    lv_subject_set_max_value_int(&settings_po2_deco_index, 10);
    lv_subject_init_int(&settings_brightness, 128);
    lv_subject_set_min_value_int(&settings_brightness, 8);
    lv_subject_set_max_value_int(&settings_brightness, 255);
    lv_subject_init_int(&settings_sleep_index, 3);
    lv_subject_set_min_value_int(&settings_sleep_index, 0);
    lv_subject_set_max_value_int(&settings_sleep_index, 5);
    static char main_o2_text_buf[UI_SUBJECT_STRING_LENGTH];
    static char main_o2_text_prev_buf[UI_SUBJECT_STRING_LENGTH];
    lv_subject_init_string(&main_o2_text,
                           main_o2_text_buf,
                           main_o2_text_prev_buf,
                           UI_SUBJECT_STRING_LENGTH,
                           "18.9"
                          );
    static char main_o2_mv_text_buf[UI_SUBJECT_STRING_LENGTH];
    static char main_o2_mv_text_prev_buf[UI_SUBJECT_STRING_LENGTH];
    lv_subject_init_string(&main_o2_mv_text,
                           main_o2_mv_text_buf,
                           main_o2_mv_text_prev_buf,
                           UI_SUBJECT_STRING_LENGTH,
                           "10.4 mV"
                          );
    static char main_he_text_buf[UI_SUBJECT_STRING_LENGTH];
    static char main_he_text_prev_buf[UI_SUBJECT_STRING_LENGTH];
    lv_subject_init_string(&main_he_text,
                           main_he_text_buf,
                           main_he_text_prev_buf,
                           UI_SUBJECT_STRING_LENGTH,
                           "45.0"
                          );
    static char main_he_mv_text_buf[UI_SUBJECT_STRING_LENGTH];
    static char main_he_mv_text_prev_buf[UI_SUBJECT_STRING_LENGTH];
    lv_subject_init_string(&main_he_mv_text,
                           main_he_mv_text_buf,
                           main_he_mv_text_prev_buf,
                           UI_SUBJECT_STRING_LENGTH,
                           "200.0 mV"
                          );
    static char main_he_temperature_text_buf[UI_SUBJECT_STRING_LENGTH];
    static char main_he_temperature_text_prev_buf[UI_SUBJECT_STRING_LENGTH];
    lv_subject_init_string(&main_he_temperature_text,
                           main_he_temperature_text_buf,
                           main_he_temperature_text_prev_buf,
                           UI_SUBJECT_STRING_LENGTH,
                           "25.0 °C"
                          );
    static char main_co_text_buf[UI_SUBJECT_STRING_LENGTH];
    static char main_co_text_prev_buf[UI_SUBJECT_STRING_LENGTH];
    lv_subject_init_string(&main_co_text,
                           main_co_text_buf,
                           main_co_text_prev_buf,
                           UI_SUBJECT_STRING_LENGTH,
                           "40"
                          );
    static char main_co_mv_text_buf[UI_SUBJECT_STRING_LENGTH];
    static char main_co_mv_text_prev_buf[UI_SUBJECT_STRING_LENGTH];
    lv_subject_init_string(&main_co_mv_text,
                           main_co_mv_text_buf,
                           main_co_mv_text_prev_buf,
                           UI_SUBJECT_STRING_LENGTH,
                           "0.0 mV"
                          );
    static char main_mod_bottom_text_buf[UI_SUBJECT_STRING_LENGTH];
    static char main_mod_bottom_text_prev_buf[UI_SUBJECT_STRING_LENGTH];
    lv_subject_init_string(&main_mod_bottom_text,
                           main_mod_bottom_text_buf,
                           main_mod_bottom_text_prev_buf,
                           UI_SUBJECT_STRING_LENGTH,
                           "B 57m"
                          );
    static char main_mod_deco_text_buf[UI_SUBJECT_STRING_LENGTH];
    static char main_mod_deco_text_prev_buf[UI_SUBJECT_STRING_LENGTH];
    lv_subject_init_string(&main_mod_deco_text,
                           main_mod_deco_text_buf,
                           main_mod_deco_text_prev_buf,
                           UI_SUBJECT_STRING_LENGTH,
                           "D 67m"
                          );
    static char main_battery_text_buf[UI_SUBJECT_STRING_LENGTH];
    static char main_battery_text_prev_buf[UI_SUBJECT_STRING_LENGTH];
    lv_subject_init_string(&main_battery_text,
                           main_battery_text_buf,
                           main_battery_text_prev_buf,
                           UI_SUBJECT_STRING_LENGTH,
                           "4.10 V"
                          );
    lv_subject_init_int(&calibration_on_start, 1);
    lv_subject_set_min_value_int(&calibration_on_start, 0);
    lv_subject_set_max_value_int(&calibration_on_start, 1);
    static char calibration_run_title_text_buf[UI_SUBJECT_STRING_LENGTH];
    static char calibration_run_title_text_prev_buf[UI_SUBJECT_STRING_LENGTH];
    lv_subject_init_string(&calibration_run_title_text,
                           calibration_run_title_text_buf,
                           calibration_run_title_text_prev_buf,
                           UI_SUBJECT_STRING_LENGTH,
                           "Calibrating"
                          );
    static char calibration_current_text_buf[UI_SUBJECT_STRING_LENGTH];
    static char calibration_current_text_prev_buf[UI_SUBJECT_STRING_LENGTH];
    lv_subject_init_string(&calibration_current_text,
                           calibration_current_text_buf,
                           calibration_current_text_prev_buf,
                           UI_SUBJECT_STRING_LENGTH,
                           "-- mV"
                          );
    static char calibration_elapsed_text_buf[UI_SUBJECT_STRING_LENGTH];
    static char calibration_elapsed_text_prev_buf[UI_SUBJECT_STRING_LENGTH];
    lv_subject_init_string(&calibration_elapsed_text,
                           calibration_elapsed_text_buf,
                           calibration_elapsed_text_prev_buf,
                           UI_SUBJECT_STRING_LENGTH,
                           "0.0 s"
                          );
    static char calibration_stability_text_buf[UI_SUBJECT_STRING_LENGTH];
    static char calibration_stability_text_prev_buf[UI_SUBJECT_STRING_LENGTH];
    lv_subject_init_string(&calibration_stability_text,
                           calibration_stability_text_buf,
                           calibration_stability_text_prev_buf,
                           UI_SUBJECT_STRING_LENGTH,
                           "Settling"
                          );
    lv_subject_init_int(&update_network_index, 0);
    lv_subject_init_int(&update_keyboard_visible, 0);
    lv_subject_set_min_value_int(&update_keyboard_visible, 0);
    lv_subject_set_max_value_int(&update_keyboard_visible, 1);
    lv_subject_init_int(&update_can_install, 0);
    lv_subject_set_min_value_int(&update_can_install, 0);
    lv_subject_set_max_value_int(&update_can_install, 1);
    static char firmware_version_text_buf[UI_SUBJECT_STRING_LENGTH];
    static char firmware_version_text_prev_buf[UI_SUBJECT_STRING_LENGTH];
    lv_subject_init_string(&firmware_version_text,
                           firmware_version_text_buf,
                           firmware_version_text_prev_buf,
                           UI_SUBJECT_STRING_LENGTH,
                           "current version: dev"
                          );
    static char update_status_text_buf[UI_SUBJECT_STRING_LENGTH];
    static char update_status_text_prev_buf[UI_SUBJECT_STRING_LENGTH];
    lv_subject_init_string(&update_status_text,
                           update_status_text_buf,
                           update_status_text_prev_buf,
                           UI_SUBJECT_STRING_LENGTH,
                           "Not connected"
                          );
    static char diagnostics_log_text_buf[UI_SUBJECT_STRING_LENGTH];
    static char diagnostics_log_text_prev_buf[UI_SUBJECT_STRING_LENGTH];
    lv_subject_init_string(&diagnostics_log_text,
                           diagnostics_log_text_buf,
                           diagnostics_log_text_prev_buf,
                           UI_SUBJECT_STRING_LENGTH,
                           "No log entries"
                          );

    /*----------------
     * Translations
     *----------------*/

    #ifndef LV_EDITOR_PREVIEW
        lv_translation_add_static(translation_languages, translation_tags, translation_texts);
        lv_translation_set_language(translation_languages[0]);
    #endif

#if defined(LV_USE_XML) && LV_USE_XML
    /* Register widgets */

    /* Check all fonts / default if needed. This prevents fonts that are used in one target but
       defined in another from causing assertion failures during rendering of the Preview. */
    check_font(&font_body_symbols, "font_body_symbols");
    check_font(&font_control, "font_control");
    check_font(&font_body, "font_body");
    check_font(&font_h5, "font_h5");
    check_font(&font_h4, "font_h4");
    check_font(&font_h3, "font_h3");
    check_font(&font_h2, "font_h2");
    check_font(&font_h1, "font_h1");

    /* Register fonts */
    lv_xml_register_font(NULL, "font_body_symbols", font_body_symbols);
    lv_xml_register_font(NULL, "font_control", font_control);
    lv_xml_register_font(NULL, "font_body", font_body);
    lv_xml_register_font(NULL, "font_h5", font_h5);
    lv_xml_register_font(NULL, "font_h4", font_h4);
    lv_xml_register_font(NULL, "font_h3", font_h3);
    lv_xml_register_font(NULL, "font_h2", font_h2);
    lv_xml_register_font(NULL, "font_h1", font_h1);

    /* Register subjects */
    lv_xml_register_subject(NULL, "subject_theme_dark", &subject_theme_dark);
    lv_xml_register_subject(NULL, "subject_brightness", &subject_brightness);
    lv_xml_register_subject(NULL, "subject_show_keyboard", &subject_show_keyboard);
    lv_xml_register_subject(NULL, "settings_o2_enabled", &settings_o2_enabled);
    lv_xml_register_subject(NULL, "settings_he_enabled", &settings_he_enabled);
    lv_xml_register_subject(NULL, "settings_co_enabled", &settings_co_enabled);
    lv_xml_register_subject(NULL, "settings_language_index", &settings_language_index);
    lv_xml_register_subject(NULL, "settings_co_correction_index", &settings_co_correction_index);
    lv_xml_register_subject(NULL, "settings_po2_bottom_index", &settings_po2_bottom_index);
    lv_xml_register_subject(NULL, "settings_po2_deco_index", &settings_po2_deco_index);
    lv_xml_register_subject(NULL, "settings_brightness", &settings_brightness);
    lv_xml_register_subject(NULL, "settings_sleep_index", &settings_sleep_index);
    lv_xml_register_subject(NULL, "main_o2_text", &main_o2_text);
    lv_xml_register_subject(NULL, "main_o2_mv_text", &main_o2_mv_text);
    lv_xml_register_subject(NULL, "main_he_text", &main_he_text);
    lv_xml_register_subject(NULL, "main_he_mv_text", &main_he_mv_text);
    lv_xml_register_subject(NULL, "main_he_temperature_text", &main_he_temperature_text);
    lv_xml_register_subject(NULL, "main_co_text", &main_co_text);
    lv_xml_register_subject(NULL, "main_co_mv_text", &main_co_mv_text);
    lv_xml_register_subject(NULL, "main_mod_bottom_text", &main_mod_bottom_text);
    lv_xml_register_subject(NULL, "main_mod_deco_text", &main_mod_deco_text);
    lv_xml_register_subject(NULL, "main_battery_text", &main_battery_text);
    lv_xml_register_subject(NULL, "calibration_on_start", &calibration_on_start);
    lv_xml_register_subject(NULL, "calibration_run_title_text", &calibration_run_title_text);
    lv_xml_register_subject(NULL, "calibration_current_text", &calibration_current_text);
    lv_xml_register_subject(NULL, "calibration_elapsed_text", &calibration_elapsed_text);
    lv_xml_register_subject(NULL, "calibration_stability_text", &calibration_stability_text);
    lv_xml_register_subject(NULL, "update_network_index", &update_network_index);
    lv_xml_register_subject(NULL, "update_keyboard_visible", &update_keyboard_visible);
    lv_xml_register_subject(NULL, "update_can_install", &update_can_install);
    lv_xml_register_subject(NULL, "firmware_version_text", &firmware_version_text);
    lv_xml_register_subject(NULL, "update_status_text", &update_status_text);
    lv_xml_register_subject(NULL, "diagnostics_log_text", &diagnostics_log_text);

    /* Register callbacks */
#endif

    /* Register all the global assets so that they won't be created again when globals.xml is parsed.
     * While running in the editor skip this step to update the preview when the XML changes */
#if defined(LV_USE_XML) && LV_USE_XML && !defined(LV_EDITOR_PREVIEW)
    /* Register images */
    lv_xml_register_image(NULL, "phony_divers_logo", phony_divers_logo);
    lv_xml_register_image(NULL, "icon_arrow_down", icon_arrow_down);
    lv_xml_register_image(NULL, "icon_arrow_left", icon_arrow_left);
    lv_xml_register_image(NULL, "icon_arrow_right", icon_arrow_right);
    lv_xml_register_image(NULL, "icon_arrow_up", icon_arrow_up);
    lv_xml_register_image(NULL, "icon_battery", icon_battery);
    lv_xml_register_image(NULL, "icon_battery_full", icon_battery_full);
    lv_xml_register_image(NULL, "icon_bell", icon_bell);
    lv_xml_register_image(NULL, "icon_bluetooth", icon_bluetooth);
    lv_xml_register_image(NULL, "icon_calendar", icon_calendar);
    lv_xml_register_image(NULL, "icon_camera", icon_camera);
    lv_xml_register_image(NULL, "icon_check", icon_check);
    lv_xml_register_image(NULL, "icon_chevron_down", icon_chevron_down);
    lv_xml_register_image(NULL, "icon_chevron_left", icon_chevron_left);
    lv_xml_register_image(NULL, "icon_chevron_right", icon_chevron_right);
    lv_xml_register_image(NULL, "icon_chevron_up", icon_chevron_up);
    lv_xml_register_image(NULL, "icon_clock", icon_clock);
    lv_xml_register_image(NULL, "icon_close", icon_close);
    lv_xml_register_image(NULL, "icon_download", icon_download);
    lv_xml_register_image(NULL, "icon_edit", icon_edit);
    lv_xml_register_image(NULL, "icon_heart", icon_heart);
    lv_xml_register_image(NULL, "icon_home", icon_home);
    lv_xml_register_image(NULL, "icon_info", icon_info);
    lv_xml_register_image(NULL, "icon_lock", icon_lock);
    lv_xml_register_image(NULL, "icon_mail", icon_mail);
    lv_xml_register_image(NULL, "icon_menu", icon_menu);
    lv_xml_register_image(NULL, "icon_minus", icon_minus);
    lv_xml_register_image(NULL, "icon_moon", icon_moon);
    lv_xml_register_image(NULL, "icon_pause", icon_pause);
    lv_xml_register_image(NULL, "icon_play", icon_play);
    lv_xml_register_image(NULL, "icon_plus", icon_plus);
    lv_xml_register_image(NULL, "icon_power", icon_power);
    lv_xml_register_image(NULL, "icon_refresh", icon_refresh);
    lv_xml_register_image(NULL, "icon_search", icon_search);
    lv_xml_register_image(NULL, "icon_settings", icon_settings);
    lv_xml_register_image(NULL, "icon_signal", icon_signal);
    lv_xml_register_image(NULL, "icon_star", icon_star);
    lv_xml_register_image(NULL, "icon_sun", icon_sun);
    lv_xml_register_image(NULL, "icon_trash", icon_trash);
    lv_xml_register_image(NULL, "icon_unlock", icon_unlock);
    lv_xml_register_image(NULL, "icon_upload", icon_upload);
    lv_xml_register_image(NULL, "icon_user", icon_user);
    lv_xml_register_image(NULL, "icon_volume", icon_volume);
    lv_xml_register_image(NULL, "icon_wifi", icon_wifi);
    lv_xml_register_image(NULL, "icon_wifi_high", icon_wifi_high);
    lv_xml_register_image(NULL, "icon_wifi_low", icon_wifi_low);
    lv_xml_register_image(NULL, "icon_wifi_zero", icon_wifi_zero);
#endif

#if !defined(LV_USE_XML) || LV_USE_XML == 0
    /*--------------------
     *  Permanent screens
     *-------------------*/
    /* If XML is enabled it's assumed that the permanent screens are created
     * manually from XML using lv_xml_create() */
    largescr_create();
    mainscr_create();
#endif
}

void lvgl_ui_project_set_target(uint32_t target)
{
    lvgl_ui_project_target = target;
}

uint32_t lvgl_ui_project_get_target(void)
{
    return lvgl_ui_project_target;
}

bool lvgl_ui_project_check_target(uint32_t target)
{
    return (lvgl_ui_project_target & target) ? true : false;
}

/* Callbacks */

/**********************
 *   STATIC FUNCTIONS
 **********************/

static void check_font(lv_font_t ** font, const char * name)
{
    if (!(*font)) {
        *font = (lv_font_t *)LV_FONT_DEFAULT;
        LV_LOG_WARN("font `%s` was not set. Using `LV_FONT_DEFAULT` instead", name);
    }
}
