vldgeorgiev/scuba-gas-analyzer/lvgl-ui-project/lvgl_ui_project.c

/**
 * @file lvgl_ui_project.c
 */

/*********************
 *      INCLUDES
 *********************/

#include "lvgl_ui_project.h"

/*********************
 *      DEFINES
 *********************/

/**********************
 *      TYPEDEFS
 **********************/

/**********************
 *  STATIC PROTOTYPES
 **********************/

/**********************
 *  STATIC VARIABLES
 **********************/

/**********************
 *      MACROS
 **********************/

/**********************
 *   GLOBAL FUNCTIONS
 **********************/

void lvgl_ui_project_init(const char * asset_path)
{
    LV_LOG("Initializing custom C code using LVGL v%d.%d.%d", LVGL_VERSION_MAJOR, LVGL_VERSION_MINOR, LVGL_VERSION_PATCH);

    lvgl_ui_project_init_gen(asset_path);

    /* Add your own custom code here if needed */
}

/**********************
 *   STATIC FUNCTIONS
 **********************/
