vldgeorgiev/scuba-gas-analyzer/src/display/UiPresentation.h

#pragma once

#include <cstdio>
#include "sensors/sensors.h"
#include "settings/Settings.h"

namespace ui {

inline int estimatedBatteryLevel(float voltage) {
  if (!std::isfinite(voltage) || voltage <= 0) return -1;
  static constexpr float voltages[] = {3.0f, 3.5f, 3.6f, 3.7f, 3.8f, 3.9f, 4.0f, 4.1f, 4.2f};
  static constexpr int levels[] = {0, 10, 20, 40, 60, 75, 85, 95, 100};
  if (voltage <= voltages[0]) return 0;
  for (size_t index = 1; index < sizeof(voltages) / sizeof(voltages[0]); ++index) {
    if (voltage <= voltages[index]) {
      const float fraction = (voltage - voltages[index - 1]) / (voltages[index] - voltages[index - 1]);
      return static_cast<int>(std::lround(levels[index - 1] + fraction * (levels[index] - levels[index - 1])));
    }
  }
  return 100;
}

inline void formatValue(char* text, size_t size, float value, ChannelState state,
                        const char* format) {
  if (state != ChannelState::Valid) {
    std::snprintf(text, size, "%s", channelStateText(state));
  } else if (!std::isfinite(value)) {
    std::snprintf(text, size, "Invalid");
  } else {
    std::snprintf(text, size, format, static_cast<double>(value));
  }
}

inline void formatMod(char* text, size_t size, const char* prefix, float po2,
                      float oxygen, ChannelState state) {
  int depth;
  if (state != ChannelState::Valid ||
      !conversions::toInt(conversions::maximumOperatingDepth(po2, oxygen), depth) || depth < 0) {
    std::snprintf(text, size, "%s --m", prefix);
  } else {
    std::snprintf(text, size, "%s %dm", prefix, depth);
  }
}

inline void formatMeasurementError(char* text, size_t size, const sensorsData& data) {
  text[0] = '\0';
  size_t used = 0;
  const auto appendInvalid = [&](const char* sensor, float value, const char* unit) {
    if (used >= size) return;
    const int written = std::isfinite(value)
        ? std::snprintf(text + used, size - used, "%s%s invalid: %.1f %s",
                        used ? "; " : "", sensor, static_cast<double>(value), unit)
        : std::snprintf(text + used, size - used, "%s%s invalid: unavailable",
                        used ? "; " : "", sensor);
    if (written > 0) used += static_cast<size_t>(written);
  };
  if (data.o2State == ChannelState::Invalid) appendInvalid("O2", data.O2Level.millivolts, "mV");
  if (data.coState == ChannelState::Invalid) appendInvalid("CO", data.CoLevel.millivolts, "mV");
  if (data.heState == ChannelState::Invalid) appendInvalid("He", data.HeLevel.millivolts, "mV");
  if (data.temperatureState == ChannelState::Invalid) {
    appendInvalid("He temperature", data.HeTemperature, "C");
  }
  if (!used) std::snprintf(text, size, "Invalid sensor reading");
}

inline int po2Selection(float value) {
  return std::isfinite(value) ? static_cast<int>(std::lround((value - 1.0f) * 10.0f)) : -1;
}

// Dropdown lists corrections from the maximum down to the minimum.
inline int coCorrectionSelection(int8_t correctionPpm) {
  return app::CO_CORRECTION_MAX_PPM - correctionPpm;
}

inline bool applySelections(AnalyzerSettings& candidate, int bottom, int deco,
                            int brightness, int sleep, int coCorrection) {
  const int sleepCount = sizeof(app::SLEEP_OPTIONS) / sizeof(app::SLEEP_OPTIONS[0]);
  const int coCorrectionPpm = app::CO_CORRECTION_MAX_PPM - coCorrection;
  if (bottom < 0 || bottom > 6 || deco < 0 || deco > 10 ||
      brightness < 8 || brightness > 255 || sleep < 0 || sleep >= sleepCount ||
      !AnalyzerSettings::validCoCorrection(coCorrectionPpm)) return false;
  AnalyzerSettings updated = candidate;
  if (bottom != po2Selection(updated.po2Bottom)) updated.po2Bottom = 1.0f + bottom / 10.0f;
  if (deco != po2Selection(updated.po2Deco)) updated.po2Deco = 1.0f + deco / 10.0f;
  updated.brightness = static_cast<uint8_t>(brightness);
  updated.sleepMinutes = app::SLEEP_OPTIONS[sleep];
  updated.coCorrectionPpm = static_cast<int8_t>(coCorrectionPpm);
  if (!updated.valid()) return false;
  candidate = updated;
  return true;
}

}
