vldgeorgiev/scuba-gas-analyzer/src/ui-log.h

#ifndef UILOG_H
#define UILOG_H

#include <esp32-hal.h>
#include "freertos/FreeRTOS.h"
#include "freertos/semphr.h"
#include "string.h"

using esp_hal_millis = decltype(::millis);

enum class UiLogLevel {
  None,     // No warning/error icon shown in the UI
  Warning,
  Error,
  Unchanged // Indicates no change to the log level
};

// TODO the buffer is slow combined with the UI and a bit buggy, improve it later
class UiLog {
public:
  static constexpr size_t kLogSnapshotSize = 500;

  static UiLog& getInstance() {
    static UiLog instance;
    return instance;
  }

  void addLogEntry(const char* txt, UiLogLevel level = UiLogLevel::Unchanged) {
    if (xSemaphoreTake(mutex, pdMS_TO_TICKS(100)) != pdTRUE) {
      // Don't block indefinitely - ESP32 should be responsive
      return;
    }

    if (level != UiLogLevel::Unchanged) {
      this->level = level;
    }

    // Use millis() instead of esp_timer for better performance
    uint32_t timeMs = ::millis();

    // Pre-calculate maximum possible entry length to avoid double formatting
    const uint16_t maxEntryLen = 50; // "[12345678] " + message + "\n\0"
    uint16_t txtLen = strlen(txt);
    if (txtLen > bufferSize - maxEntryLen) {
      txtLen = bufferSize - maxEntryLen; // Truncate if too long
    }

    // Calculate actual entry length
    uint16_t newEntryLen = snprintf(nullptr, 0, "[%lu] ", timeMs) + txtLen + 1; // +1 for \n

    // If there's not enough space at the end of the buffer, wrap around
    if (bufferPointer + newEntryLen >= bufferSize) {
      bufferPointer = 0;
    }

    // Format directly into buffer (more efficient than double snprintf)
    int written = snprintf(logBuffer + bufferPointer, bufferSize - bufferPointer, "[%lu] ", timeMs);
    strncpy(logBuffer + bufferPointer + written, txt, txtLen);
    logBuffer[bufferPointer + written + txtLen] = '\n';
    logBuffer[bufferPointer + written + txtLen + 1] = '\0';

    bufferPointer = (bufferPointer + newEntryLen) % bufferSize;

    xSemaphoreGive(mutex);
  }

  void clearLog() {
    if (xSemaphoreTake(mutex, portMAX_DELAY)) {
      clearLogNoLock();
      xSemaphoreGive(mutex);
    }
  }

  void copyLogTo(char (&out)[kLogSnapshotSize]) const {
    out[0] = '\0';
    if (xSemaphoreTake(mutex, portMAX_DELAY) != pdTRUE) return;
    const uint16_t lengthToEnd = bufferSize - bufferPointer;
    if (lengthToEnd > 0 && logBuffer[bufferPointer] == '\0') {
      strncpy(out, logBuffer, bufferSize - 1);
      out[bufferSize - 1] = '\0';
    } else {
      snprintf(out, bufferSize, "%s%s", logBuffer + bufferPointer, logBuffer);
    }
    xSemaphoreGive(mutex);
  }

  UiLogLevel getLevel() const {
    UiLogLevel currentLevel;
    if (xSemaphoreTake(mutex, portMAX_DELAY)) {
      currentLevel = level;
      xSemaphoreGive(mutex);
    }
    return currentLevel;
  }

  void setLevel(UiLogLevel newLevel) {
    if (xSemaphoreTake(mutex, portMAX_DELAY)) {
      level = newLevel;
      xSemaphoreGive(mutex);
    }
  }

private:
  UiLog() {
    mutex = xSemaphoreCreateMutex();
    clearLogNoLock();
  }

  ~UiLog() {
    vSemaphoreDelete(mutex);
  }

  UiLog(const UiLog&) = delete;
  UiLog& operator=(const UiLog&) = delete;

  void clearLogNoLock() {
    bufferPointer = 0;
    logBuffer[0] = '\x00';
    level = UiLogLevel::None;
  }

  static const uint16_t bufferSize = kLogSnapshotSize;
  char logBuffer[bufferSize];
  uint16_t bufferPointer = 0;
  mutable SemaphoreHandle_t mutex;
  UiLogLevel level = UiLogLevel::None;
};

// Shorthand function for logging to the UI
inline void logUi(const char* txt, UiLogLevel level = UiLogLevel::Unchanged) {
  UiLog::getInstance().addLogEntry(txt, level);
}

#endif // UILOG_H
