vldgeorgiev/scuba-gas-analyzer/lvgl-ui-project/lvgl_ui.h

/**
 * @file lvgl_ui.h
 */

#ifndef LVGL_PRO_LVGL_UI_H
#define LVGL_PRO_LVGL_UI_H

#ifdef __cplusplus
extern "C" {
#endif

/*********************
 *      INCLUDES
 *********************/

#include "lvgl_ui_gen.h"

/*********************
 *      DEFINES
 *********************/

/**********************
 *      TYPEDEFS
 **********************/

/**********************
 * GLOBAL VARIABLES
 **********************/

/**********************
 * GLOBAL PROTOTYPES
 **********************/

/**
 * Initialize the component library
 */
void lvgl_ui_init(const char * asset_path);

/**********************
 *      MACROS
 **********************/

#ifdef __cplusplus
} /*extern "C"*/
#endif

#endif /*LVGL_PRO_LVGL_UI_H*/
