vldgeorgiev/scuba-gas-analyzer/(commit log)

2024-10-06 Default calibration value for 100% He, based on experiments.
2024-11-29 Helium correction in high O2%
    [HESensor.h, sensors.cpp]
2024-12-02 Use ADC gain four for the O2 and He sensors for better accuracy
2024-12-02 Convert the He mV readings to % with a polynomial function, because the sensor is non-linear. The function is experimental, to be tested and adjusted with more comparisons.
2024-12-13 Correction for He sensor non-linearity. A polynomial formula based on comparison with Divesoft Solo
    [HESensor.h]
2024-12-20 Two configs added: Brightness and Calibrate-on-startup
2025-01-26 added temperature sensor for He sensor. Display value only, no limitation of measurement yet
2025-03-01 Draft screen for the calibration outside of the settings
2025-03-03 Turn on and off the 3V/5V voltage converters for He and CO2
2026-04-03 pin and ADC configs for new PCB
2026-09-02 Pin lvgl to 9.1.0 due to breaking change in the 9.5.0
2026-09-02 Fix issue with screen brightness set to 0 - black
    [DisplayManager.cpp]
2026-09-15 Establish firmware baseline and current implementation plan
2026-09-15 Serialize sensor access before sleep coordination
2026-09-15 Add sleep preparation handshake and CO power-up interval
2026-09-15 Enable S3 inactivity deep sleep and calibration-preserving wake
2026-09-15 Fix inverted TouchLib sleep result handling
    [DisplayManager.cpp]
2026-09-15 Reset touch controller before sleep and report entry failures
    [DeviceSleep.h, DisplayManager.cpp, DisplayManager.h, main.cpp]
2026-09-15 Recover invalid saved settings without resetting valid fields
    [Analyzer.cpp, Settings.h, SettingsStore.h]
2026-09-15 Track per-channel calibration acceptance across saves and boots
2026-09-16 Switch to LVGL and remove the EEZ project
2026-09-16 Drafts for calibration, logs, firmware screens
2026-09-17 Wiring for calibration
2026-09-17 Unify calibration flow and validation
2026-09-17 Battery voltage init
2026-09-18 Fix hardware issue: The CO power pin turns off the 5V, but that also powers the temp sensor. That causes the He sensor to remain in constant wamrup without temp
    [Analyzer.cpp, Analyzer.h]
2026-09-18 Hide disabled sensors instead of showing Off
2026-09-18 Fix: The HE was showing Ivalid when O2 was disabled
    [sensors.cpp, test_sensor_reads.cpp]
2026-09-18 Add sensor details to invalid reading logs
2026-09-20 Readme power and todo
2026-10-14 CO sensor correction for offset
2026-10-14 Openscad designs for box and sensor holders
2026-10-14 Do not limit the O2 and He values to 100%. This masks calibration issues
2026-10-14 Add support for external O2 sensor through coaxial jack
2026-10-15 Colored battery indicator
2026-10-15 Battery color adjustment
2026-10-16 Calibrate on startup off by default and a warning for it
2026-10-17 Stronger flow limiter with smaller hole Slight raise in CO to reduce dead space Enforced holder inlets
2026-10-23 Make button a snap-in so it doesn't fall out
2026-10-28 Slightly stronger gas tubes with smaller inner diameter
2026-10-30 Logo printed in separate color manually
2026-11-03 Wake button a bit larger barb
2026-11-05 Fix battery voltage offset for LilyGo display
